astrolabe-expeditions/LittObs_OSOLAMOS/README.md

# LittObs-LAMOS

Ce projet est organisé en plusieurs dossiers principaux, chacun ayant un rôle spécifique :

## Structure des dossiers

- **docs/** : Documentation du projet, tutoriels et guides pour chaque module (électronique, programmation, caisson, etc.).
- **hardware/** : Contient les fichiers liés au matériel, notamment les boîtiers (`enclosures/`) et les circuits imprimés (`pcbs/`).
- **software/** : Code source et applications logicielles du projet.
	- **firmware/** : Microprogrammes embarqués pour les dispositifs électroniques.
		- **Largueur_temporel/** : Exemple de firmware Arduino pour le largueur temporel (`Largueur_temporel.ino`).
	- **mobile/** : Applications mobiles, par exemple le projet pour ESP32 (`esp32_1.aia`).

## Utilisation

Consultez le dossier `docs/` pour les instructions détaillées sur chaque module et le fonctionnement global du projet.
