astrolabe-expeditions/LittObs_OSOLAMOS/docs/module-4-caisson-enrouleur-lamos.md

---
description: >-
  Cette page vous détaille étape par étape comment construire un caisson
  enrouleur LAMOS
---

# Module 4 : Caisson enrouleur LAMOS

## Matériel

<table data-header-hidden><thead><tr><th width="109">Quantité</th><th>Matériel</th></tr></thead><tbody><tr><td>1</td><td><a href="https://www.vis-express.fr/embout-a-sertir-a-oeil-inox-a4/42806-151571-embout-a-a-sertir-a-oeil-inox-a4-diametre-5.html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">Goupille Embout à oeil à sertir Ø 5mm x L. 80mm, inox A4 316</a></td></tr><tr><td>1</td><td><a href="https://rovmaker.org/product/high-torque-40-kg-motor-micro-servo/">Servomoteur High Torque 40 KG Motor Micro Servo</a></td></tr><tr><td>0,5</td><td><a href="https://plaqueplastique.fr/product/plaque-plexiglass-noir-xt-2mm/">Plaque plexiglass épais. 2mm opaque, L. 50cm x H. 30cm</a></td></tr><tr><td>2</td><td><a href="https://plaqueplastique.fr/product/plaque-plexiglass-noir-xt-5mm/">Plaque plexiglass épais. 5mm opaque, L. 50cm x H. 30cm</a></td></tr><tr><td>36</td><td><a href="https://fr.rs-online.com/web/p/vis-a-metaux/0190440">Vis à tête cylindrique pozi M3 x L. 10mm, inox A4 316</a></td></tr><tr><td>4</td><td><a href="https://fr.rs-online.com/web/p/vis-a-metaux/0190513">Vis à tête cylindrique pozi M4 x L. 16mm, inox A4 316</a></td></tr><tr><td>12</td><td><a href="https://fr.rs-online.com/web/p/vis-a-metaux/0189428">Vis à tête cylindrique pozi M4 x L. 30mm, inox A4 316</a></td></tr><tr><td>12</td><td><a href="https://www.vis-express.fr/vis-metaux-tete-hexagonale-th-inox-a4-din-933/37747-2562188-vis-metaux-tete-hexagonale-th-m5x20-inox-a4.html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">Vis métaux Tête hexagonale M5 x 20mm, inox A4 316</a></td></tr><tr><td>16</td><td><a href="https://www.vis-express.fr/ecrou-hexagonal-hu-inox-a4-din-934-din-934-vs0100/37758-2555491-ecrou-hexagonal-hu-m4-inox-a4.html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">Écrou hexagonal M4, inox A4 316</a></td></tr><tr><td>12</td><td><a href="https://www.ruthex.de/fr/collections/gewindeeinsatze/products/ruthex-gewindeeinsatz-m5-50-stuck-rx-m5x9-5-messing-gewindebuchsen">Inserts filetés ruthex M5</a></td></tr><tr><td>30</td><td><a href="https://www.ruthex.de/fr/collections/gewindeeinsatze/products/ruthex-gewindeeinsatz-m3-100-stuck-rx-m3x5-7-messing-gewindebuchsen">Inserts filetés ruthex M3</a></td></tr><tr><td>0,25</td><td><a href="https://www.grossiste3d.com/petg/795-filament-3d-petg-1-kg-noir-175-mm-3008800007691.html">Filament 3D PETG 1kg noir 1,75 mm</a></td></tr><tr><td>1</td><td><a href="https://www.h2r-equipements.com/cordage-et-matelage-pour-bateau/29246-36212-marlow-tresse-dechaussee-excel-d12-dsk78-noir.html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">Drisse Dyneema Ø 3 mm</a></td></tr></tbody></table>

## Outils&#x20;

* Imprimante 3D&#x20;
* Découpeuse laser
* Fer à souder et étain
* Tournevis cruciformes

## Pièces :&#x20;

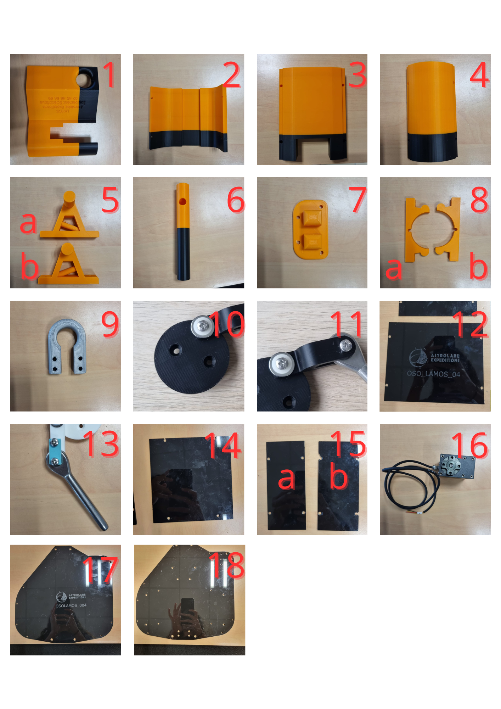
[picture p2: docs/.gitbook/assets/Pièces LAMOS LittObs (8).png]
<figure><figcaption></figcaption></figure>

## **Étape 1 : Impressions 3D**&#x20;

À l'aide d'une imprimante 3D, de filaments PETG et des fichiers ci-dessous, imprimez les pièces 1, 2, 3, 4, 5a et 5b, 6, 7, 8a et 8b, 9, 10 et 11 à 40% de remplissage.&#x20;

[https://github.com/astrolabe-expeditions/LittObs\_LAMOS/tree/896dc8c68939401ac19cc8e68da1dfa3573f5516/hardware/enclosures/body](https://github.com/astrolabe-expeditions/LittObs_LAMOS/tree/896dc8c68939401ac19cc8e68da1dfa3573f5516/hardware/enclosures/body)

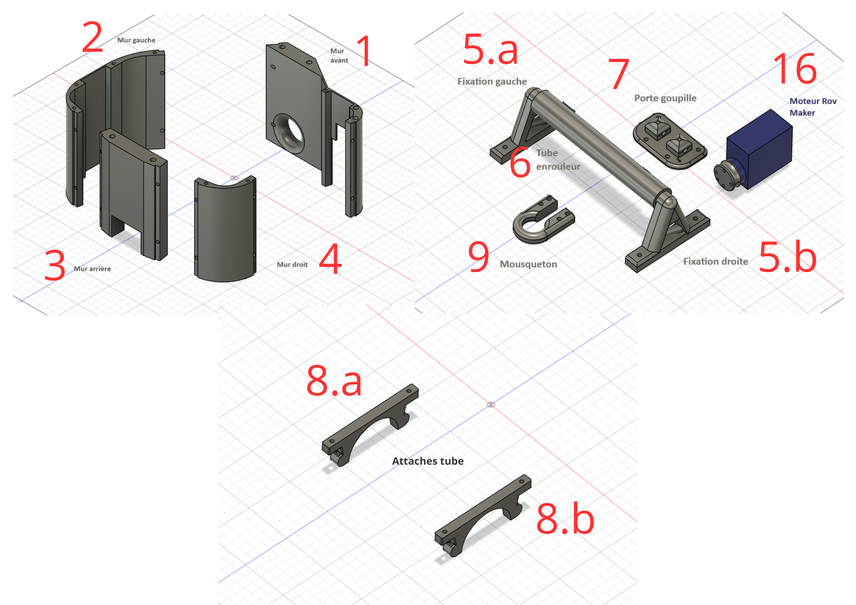
[picture p3: docs/.gitbook/assets/Pièces LAMOS LittObs (9).png]
<figure><figcaption></figcaption></figure>

## **Étape 2 : Découpes laser**&#x20;

À l'aide d'une découpeuse laser et des fichiers ci-dessous, découpez les pièces 14, 15a et 15b dans des plaques de plexiglas de 2mm et les pièces 17 et 18 dans des plaques de plexiglas de 5mm.

[https://github.com/astrolabe-expeditions/LittObs\_LAMOS/tree/896dc8c68939401ac19cc8e68da1dfa3573f5516/hardware/enclosures/body](https://github.com/astrolabe-expeditions/LittObs_LAMOS/tree/896dc8c68939401ac19cc8e68da1dfa3573f5516/hardware/enclosures/body)

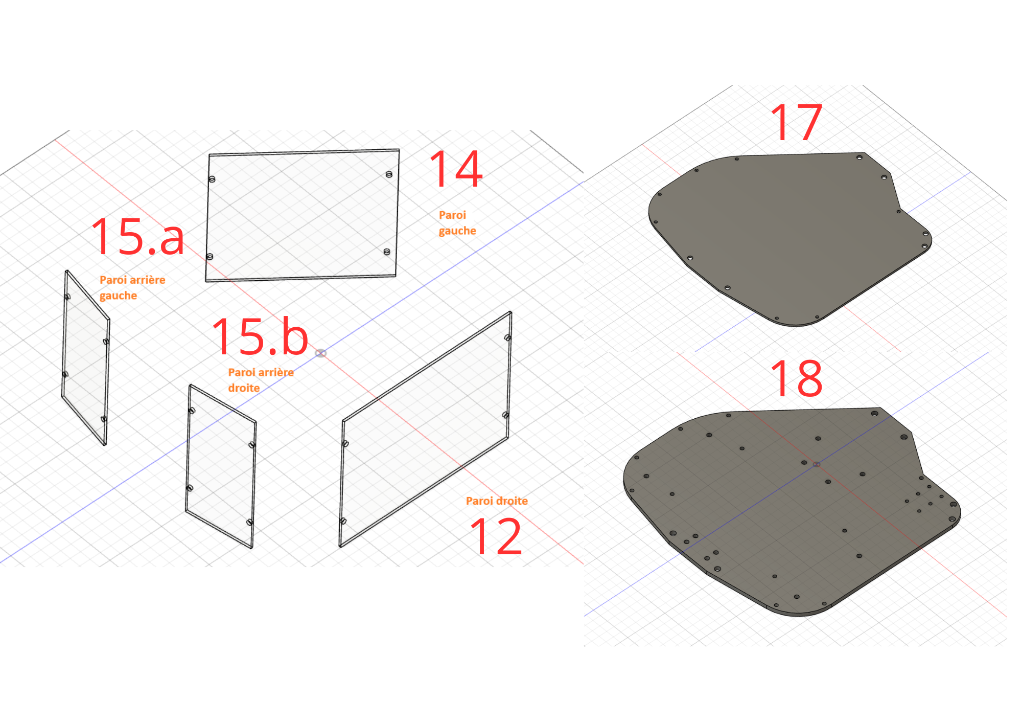
[picture p4: docs/.gitbook/assets/Pièces LAMOS LittObs (10).png]
<figure><figcaption></figcaption></figure>

## **Étape 3 : Insérer les inserts filetés dans les parois 3D**

Positionnez les inserts filetés sur les pièces 3D au niveau des trous prévus à cet effet. Puis, faites chauffer les inserts avec un fer à souder afin de les insérer dans les pièces 3D. (Pas besoin d’inserts pour les pièces : 04, 05a, 05b, 07, 08a et 08b)

Attention à ce que la chaleur du fer à souder ne crée pas des bourrelets autour des inserts ! Le cas échéant, limez les pièces 3D afin de garder une surface lisse.

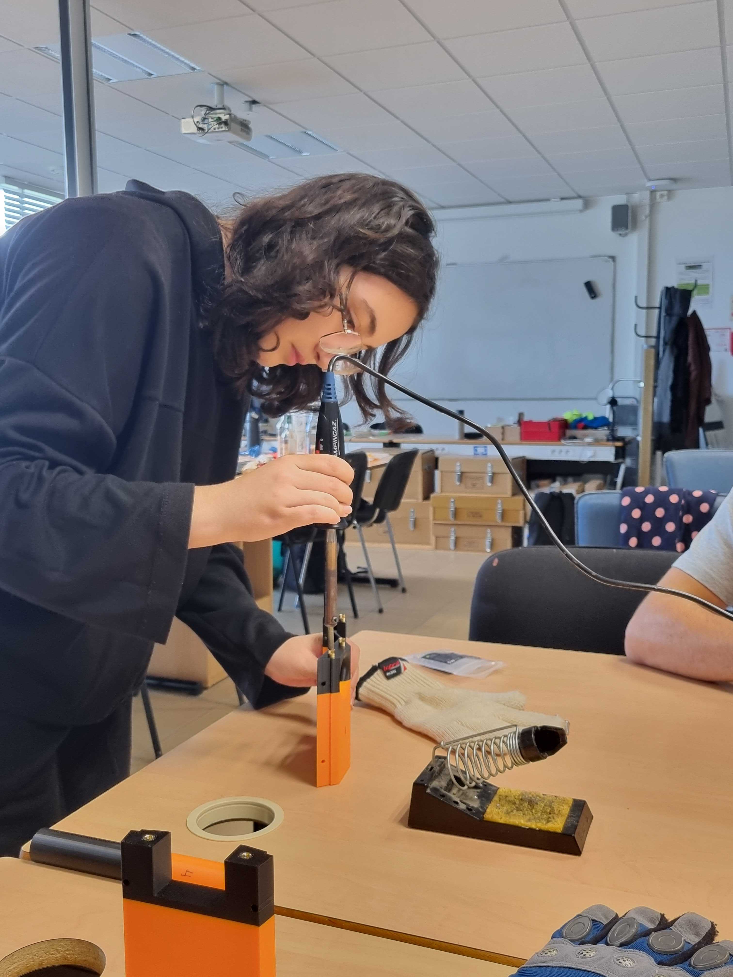
[picture p5: docs/.gitbook/assets/1000056525 (1).jpg]
<div align="center"><figure><figcaption></figcaption></figure></div>

## **Étape 4 : Assemblage des murs et parois**

**À partir du schéma suivant :**

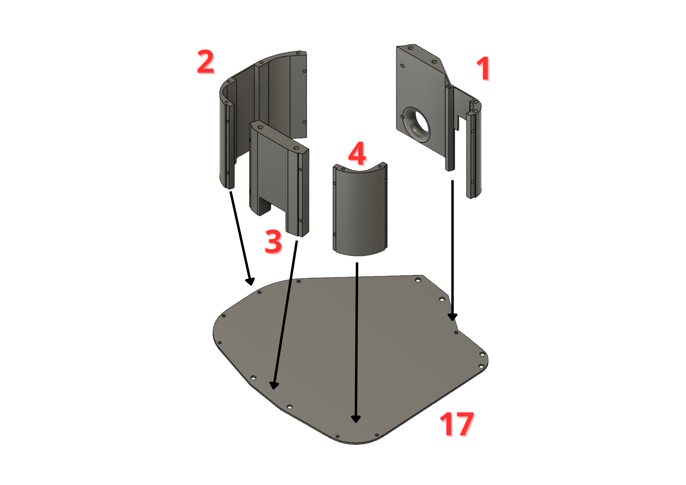
[picture p6: docs/.gitbook/assets/Pièces LAMOS LittObs (11) (1).png]
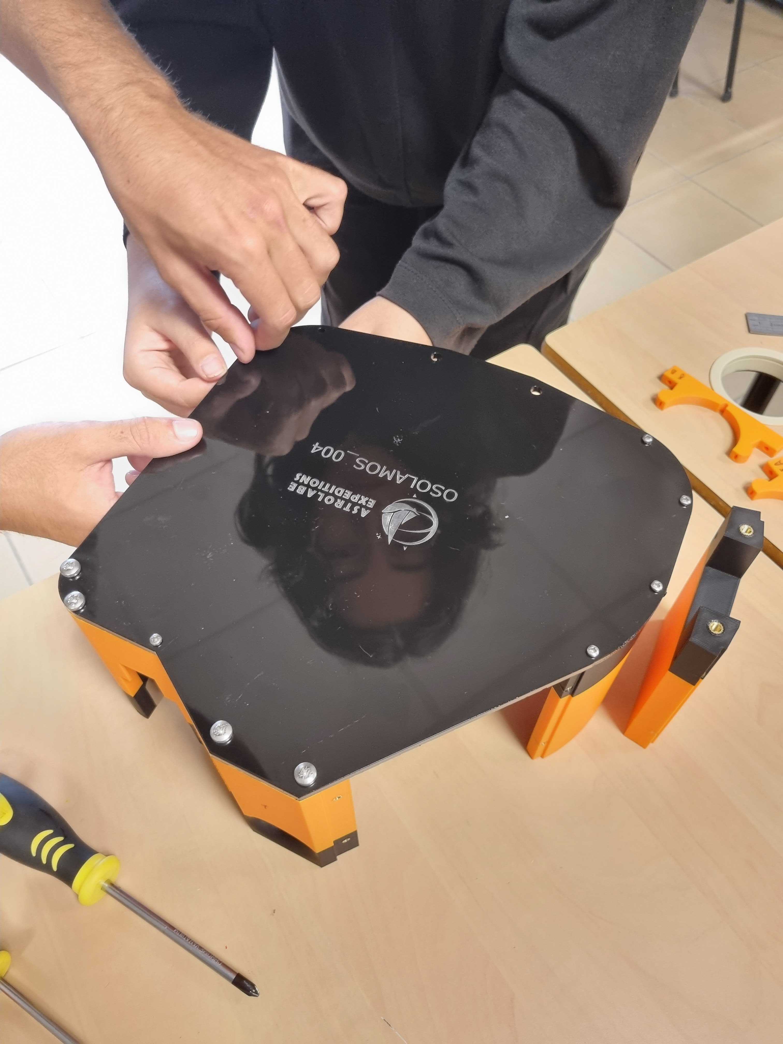
[picture p7: docs/.gitbook/assets/20250918_185842 (1).jpg]
<div><figure><figcaption></figcaption></figure> <figure><figcaption></figcaption></figure></div>

Vissez les pièces 01, 02, 03 et 04 sur la plaque en plexiglas 17

* 01 (mur avant) à l’aide de 1 petite vis M3 10mm et 4 grandes vis M5
* 02 (mur gauche) à l’aide de 4 petites vis M3 10mm
* 03 (mur arrière) à l’aide de 2 grandes vis M5
* 04 (mur droit) à l’aide de 2 petites vis M3 10mm

**À partir du schéma suivant :**

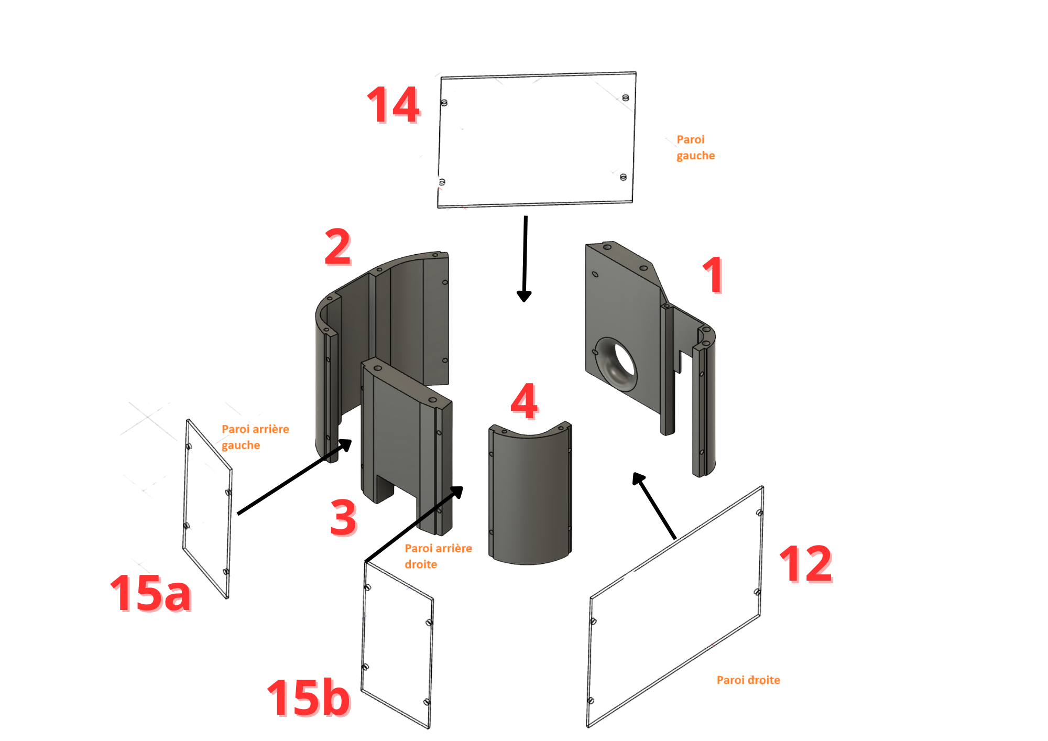
[picture p8: docs/.gitbook/assets/Pièces LAMOS LittObs (12).png]
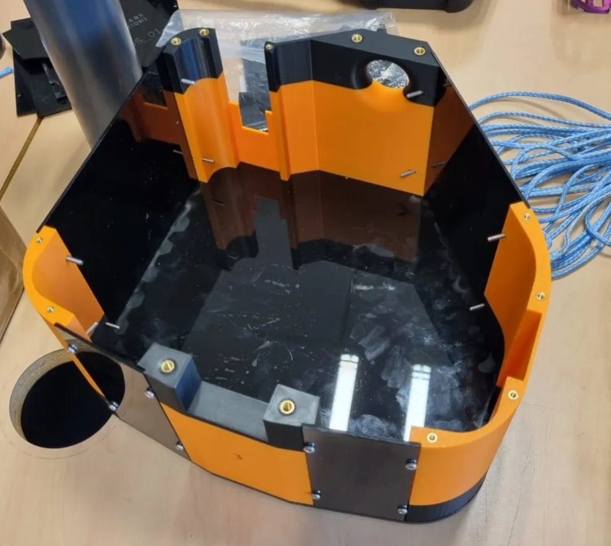
[picture p9: docs/.gitbook/assets/WhatsApp Image 2025-10-08 at 18.09.54.jpeg.png]
<div><figure><figcaption></figcaption></figure> <figure><figcaption></figcaption></figure></div>

* Vissez la paroi arrière gauche (15a) entre les pièces 02 et 03 avec 04 petites vis M3
* Vissez la paroi arrière droite (15b) entre les pièces 03 et 06 avec 04 petites vis M3

<mark style="color:$warning;">ATTENTION les parois 15a et 15b ne font pas la même taille ! 15a est plus petite que 15b</mark>

* Vissez la paroi gauche (14) entre les pièces 02 et 03 avec 4 petites vis M3
* Vissez la paroi droite (19) entre les pièces 01 et 06 avec 4 petites vis M3

Si les plaques ne se positionnent pas bien face aux inserts, créez un peu de jeu avec les vis.

## **Étape 5 : Fixer et enrouler la drisse dans la bobine**

**Insérer la drisse 6mm dans l'enrouleur (6) au niveau du trou prévu à cet effet, puis réaliser un nœud de blocage. Si le trou n'est pas adapté au diamètre du bout, ne pas hésiter à repercer l'enrouleur d'un diamètre plus adapté).**

**Enrouler la longueur totale du bout autour de la bobine. Puis placer la bobine dans les 2 supports (5a et 5b).**

## **Étape 5 : Assembler le système de largage**

* Assembler le système de largage goupille :&#x20;
  * En vissant la bielle (10) avec la manivelle (11) à l’aide d’une vis M4 et d’une ou deux rondelles
  * En fixant la goupille (13) sur la manivelle par l'intermédiaire du petit anneau imprimé en 3D ainsi qu'un vis M4

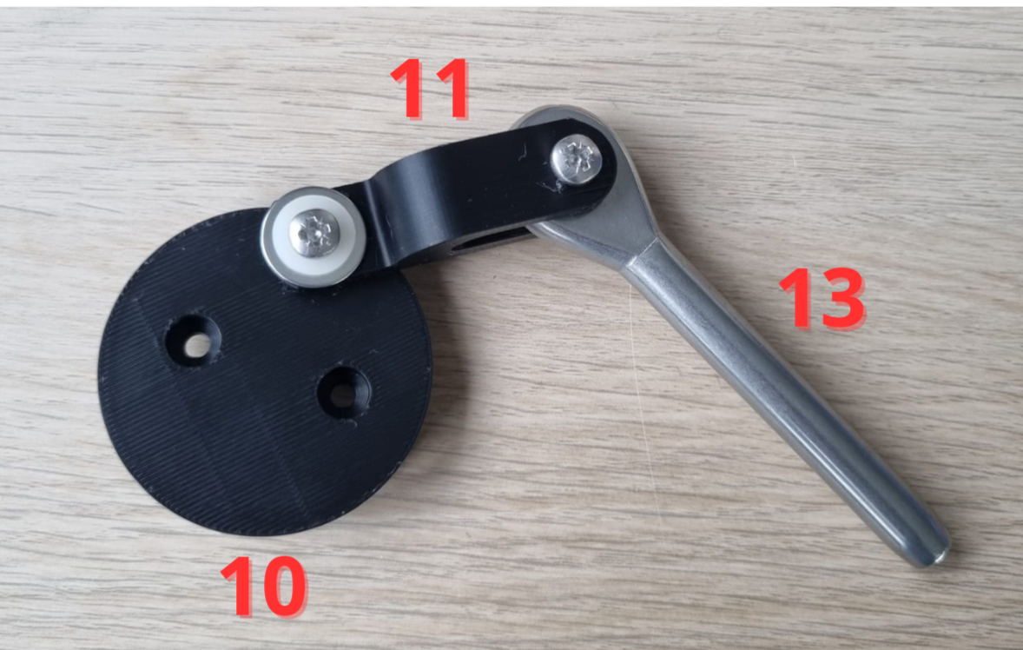
[picture p10: docs/.gitbook/assets/Pièces LAMOS LittObs (14).png]
<figure><figcaption></figcaption></figure>

**À partir du schéma suivant et en suivant l'ordre des étapes :**

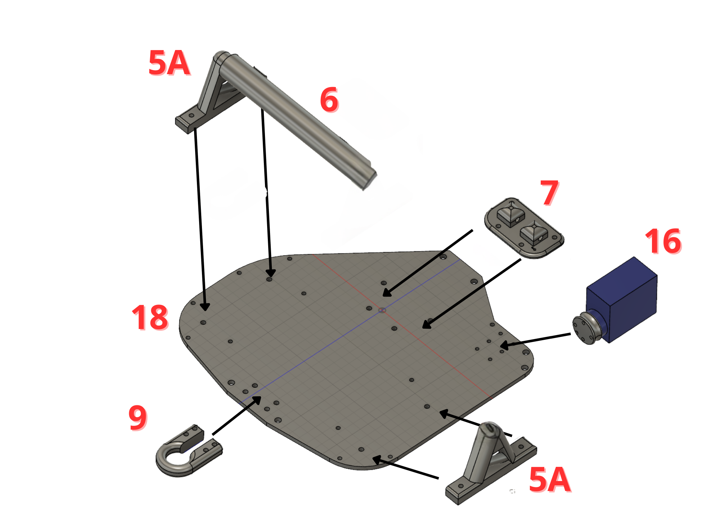
[picture p11: docs/.gitbook/assets/Pièces LAMOS LittObs (13).png]
<figure><figcaption></figcaption></figure>

<div><figure><figcaption></figcaption></figure> <figure><figcaption></figcaption></figure></div>

* Fixer sur la seconde paroi plexiglas (18) les pièces suivantes :
  *   Le servomoteur (16) avec 6 petites visses M3. Le système de largage précédemment assemblé doit être fixé sur la partie rotative du servomoteur (16) à l'aide de vis à tête fraisée M4 de 10mm

      *

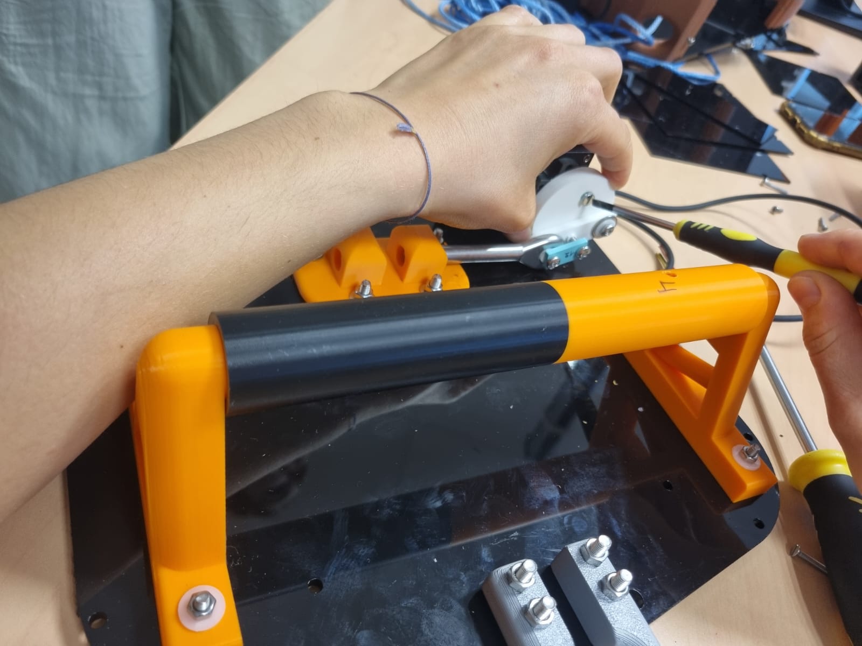
[picture p12: docs/.gitbook/assets/WhatsApp Image 2025-09-25 at 19.36.06 (1) (1).jpeg]
          <figure><figcaption></figcaption></figure>

  * Le porte goupille (7) à l’aide de 4 grandes vis M5 et 4 écrous. Puis glisser la goupille (13).
  * L'ensemble de l'enrouleur comprenant les fixation gauche et droites (5a et 5b) ainsi que la bobine et la drisse (6)
  * Le mousqueton (9) à l’aide de 4 grandes vis M5 et 4 écrous.
* Sur l’autre face de la paroi plexiglas (18), fixer les pièces 8a et 8b avec des 4 vis M4 de 25mm

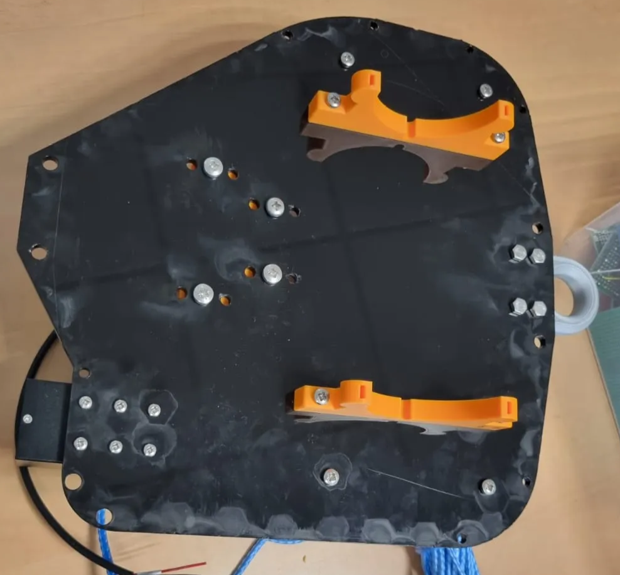
[picture p13: docs/.gitbook/assets/WhatsApp Image 2025-10-08 at 18.09.49.jpeg.png]
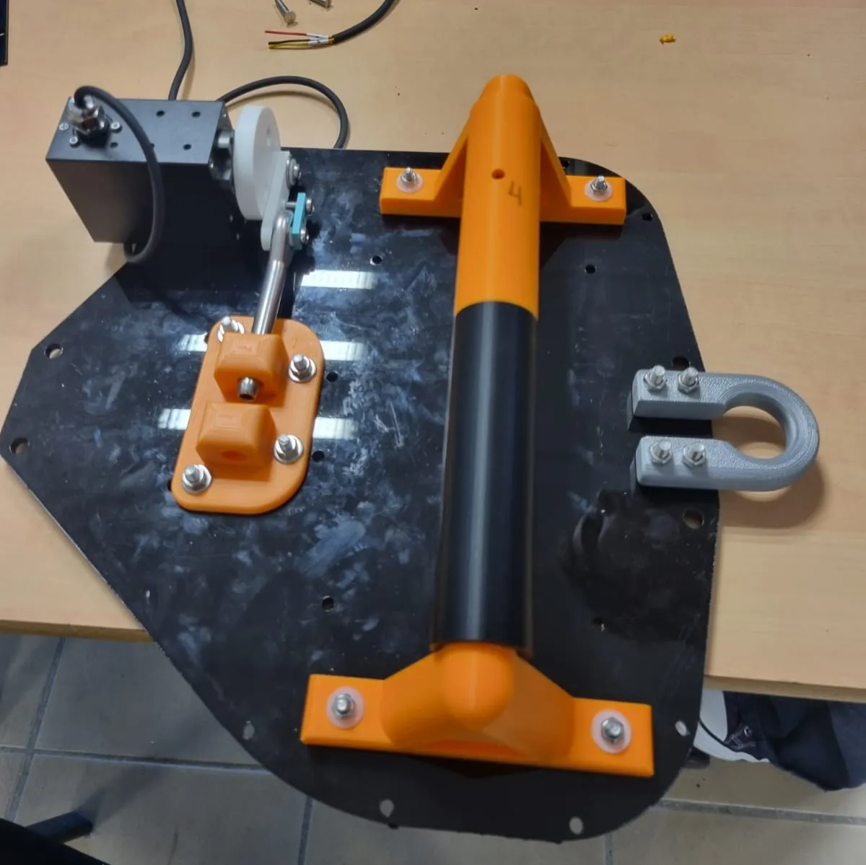
[picture p14: docs/.gitbook/assets/WhatsApp Image 2025-09-25 at 19.36.00.jpeg.png]
<div><figure><figcaption></figcaption></figure> <figure><figcaption></figcaption></figure></div>

<mark style="color:$warning;">Attention à visser les écrous du côté des pièces 3D afin de garder la surface extérieure de la plaque facilement manipulable à la main !</mark>

## **Étape 6 : Assembler l'ensemble**

Visser la pièce 18 avec les murs 01, 02,03 et 04 à l'aide de vis M5 et M3 10mm.

<div><figure><figcaption></figcaption></figure> <figure><figcaption></figcaption></figure></div>
