astrolabe-expeditions/LittObs_OSOLAMOS/docs/module-1-carte-electronique-lamos.md

---
description: Page en construction...
---

# Module 1 : Carte électronique LAMOS

## Matériel :&#x20;

<table><thead><tr><th width="118.33331298828125">Quantité</th><th>Matériel</th></tr></thead><tbody><tr><td>1</td><td><a href="https://jlcpcb.com/">PCB à imprimer</a></td></tr><tr><td>1</td><td><a href="https://www.gotronic.fr/art-module-firebeetle-esp32-dfr0478-26810.htm">Module FireBeetle ESP32 DFR0478</a></td></tr><tr><td>1</td><td><a href="https://www.gotronic.fr/art-module-rtc-i2c-ds3231m-dfr0641-32243.htm">Module RTC I2C DS3231M DFR0641</a></td></tr><tr><td>1</td><td><a href="https://eu.robotshop.com/products/servocity-xt30-lead-fh-mc-300mm-length?qd=b64ee6ad88995350cdadd1edb00deb69">Connecteur XT30 femelle</a></td></tr><tr><td>1</td><td><a href="https://www.gotronic.fr/art-connecteur-nsk254-4-15396.htm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">Connecteur 4 broches mâle</a></td></tr><tr><td>1</td><td><a href="https://www.gotronic.fr/art-connecteur-nsk254-4f-37679.htm">Connecteur 4 broches femelle</a></td></tr><tr><td>2</td><td><a href="https://www.gotronic.fr/art-connecteur-fh1x18-35647.htm">Connecteurs femelles FH1X18 18 contacts, 2,54mm</a></td></tr><tr><td>2</td><td><a href="https://www.gotronic.fr/art-connecteur-fh1x7-22733.htm">Connecteurs femelles FH1X7 7 contacts, 2,54mm</a></td></tr><tr><td>1</td><td><a href="https://www.gotronic.fr/art-10-resistances-1-4w-470-8486-2571.htm">Résistance 1/2W 470 Ω</a></td></tr><tr><td>1</td><td><a href="https://www.gotronic.fr/art-assortiment-de-50-leds-36117.htm">Led 5mm verte 2 mA</a></td></tr><tr><td>1</td><td><a href="https://fr.rs-online.com/web/p/interrupteurs-a-glissiere/7347296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;matchtype=&#x26;&#x26;gclsrc=aw.ds&#x26;gad_source=1&#x26;gad_campaignid=20705694603&#x26;gclid=Cj0KCQjw6bfHBhDNARIsAIGsqLhk2r94cKffPtzz0kw8niXHl5YC2BkwRsuroMJeFyVusfk3wwECJnkaAnhsEALw_wcB">Commutateur à glissière, 1RT, Verrouillable, 5A, 28 Vcc</a></td></tr><tr><td>1</td><td><a href="https://eu.robotshop.com/fr/products/bluerobotics-wetlink-penetrator-lc-1-pack-m10-55-mm">BlueRobotics WetLink Penetrator M10-5.5mm-LC</a></td></tr><tr><td>1</td><td><a href="https://eu.robotshop.com/products/bluerobotics-switch-5a?qd=ceadcef33edf15892b1a770253882463">BlueRobotics Switch 5A</a></td></tr><tr><td>1</td><td><a href="https://www.gotronic.fr/art-module-bouton-poussoir-on-off-6a-2808-24231.htm">Pololu Mini Pushbutton Power Switch LV from 2.2 V to 20 V</a></td></tr><tr><td>1</td><td><a href="https://www.nkon.nl/fr/samsung-inr18650-35e.html">Batterie 18650 3400mAh 8A (/!\ la référence change régulièrement)</a></td></tr><tr><td>1</td><td><a href="https://www.nkon.nl/fr/1x-18650-batterijhouder-met-klemmen-en-losse-draden.html">Support batterie 18650</a></td></tr><tr><td>3</td><td><a href="https://www.nkon.nl/fr/samsung-inr18650-35e.html">Batterie 18650 3400mAh 8A (/!\ la référence change régulièrement)</a></td></tr><tr><td>1</td><td><a href="https://fr.aliexpress.com/item/1005007538224600.html?UTABTest=aliabtest110382_7684&#x26;src=google&#x26;src=google&#x26;albch=shopping&#x26;acnt=248-630-5778&#x26;slnk=&#x26;plac=&#x26;mtctp=&#x26;albbt=Google_7_shopping&#x26;gclsrc=aw.ds&#x26;albagn=888888&#x26;ds_e_adid=&#x26;ds_e_matchtype=&#x26;ds_e_device=c&#x26;ds_e_network=x&#x26;ds_e_product_group_id=&#x26;ds_e_product_id=fr1005007538224600&#x26;ds_e_product_merchant_id=5422775200&#x26;ds_e_product_country=FR&#x26;ds_e_product_language=fr&#x26;ds_e_product_channel=online&#x26;ds_e_product_store_id=&#x26;ds_url_v=2&#x26;albcp=19000710609&#x26;albag=&#x26;isSmbAutoCall=false&#x26;needSmbHouyi=false&#x26;gad_source=1&#x26;gclid=Cj0KCQiA_NC9BhCkARIsABSnSTbT6iz-yaQ0HdWFSCa2HC2KcABTsam-IVa1xElwvAvcU64eQtP46s4aAioJEALw_wcB&#x26;aff_fcid=efed48fa4b1e4580805efe8ff2b32c29-1739892689495-01463-UneMJZVf&#x26;aff_fsk=UneMJZVf&#x26;aff_platform=aaf&#x26;sk=UneMJZVf&#x26;aff_trace_key=efed48fa4b1e4580805efe8ff2b32c29-1739892689495-01463-UneMJZVf&#x26;terminal_id=62d61d252d2149ddb2b1251d52458886&#x26;OLP=1098900508_f_group4&#x26;o_s_id=1098900508&#x26;afSmartRedirect=n&#x26;gatewayAdapt=glo2fra">Carte de protection de batterie BMS 3S 20A 12.6V</a></td></tr><tr><td>1</td><td><a href="https://eu.robotshop.com/products/servocity-xt30-lead-mh-fc-300mm-length?qd=b077e74b9c723d089f742c476480a82b">Connecteur XT30 mâle</a></td></tr><tr><td>1</td><td><a href="https://www.amazon.fr/TA-VIGOR-Gaine-thermor%C3%A9tractable-batterie-18650/dp/B0DZ2KYX4D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;dib=eyJ2IjoiMSJ9._vSXqGemJ-ZPZgqzORLRd7WxjtNvmwjq-jpn86XdISOZswNncPag6kXENnDYJz51sSau_qbNMs_-zvGCprQUulaiVunPPsxY30zscNwd9NiTfXLkQ2FCDaoJy-TWTKNnzmXdDwzKZMmS5CrKFgb_ZMFJineflT9CMSY6Q-8jB-lhD84CmdnKK22sxJZAydFpx3gvPai1lcENDaI4fB3vYmCzhDbFZ2-f2MD9Otr_LqUkkAHDlaWsxJYoISMxqkUdjDKXuG49mrGVLCF9tHdUJeGlrdJJO9iX84ZJ8-thf84.rUn-jwb9zU7lFT0vi1m9xXH5IOB2vopwIP2zC5o8D7E&#x26;dib_tag=se&#x26;keywords=Gaine%2Bthermo-r%C3%A9tractable%2BPVC%2Bbleue%2Bpour%2Bbatterie%2B18650%2C%2BL.%2B85mm%2B1m&#x26;qid=1760692967&#x26;sbo=RZvfv%2F%2FHxDF%2BO5021pAnSA%3D%3D&#x26;sprefix=gaine%2Bthermo-r%C3%A9tractable%2Bpvc%2Bbleue%2Bpour%2Bbatterie%2B18650%2C%2Bl.%2B85mm%2B1m%2Caps%2C103&#x26;sr=8-6&#x26;th=1">Gaine thermo-rétractable PVC bleue pour batterie 18650, L. 85mm</a></td></tr><tr><td>1</td><td><a href="https://www.nkon.nl/fr/nikkel-weldingstrip-7mm-0-12mm.html">Bande de soudure au nickel de 1 mètre - 7 mm * 0,12 mm</a></td></tr></tbody></table>

## Outils :&#x20;

*
  Fils électriques
* Ruban adhésif d'électricité chatterton
* Fer à souder
* Étain
* Soudeuse par points à pédale
* Multimètre
* Lunettes de protection
* Pince coupante et pince à dénuder

### Commande ou impression du PCB

Commander le PCB via un site tel que JLCPCB ou le découper via une fraiseuse numérique CNC grâce aux fichiers gerber "[Gerber\_PCB\_LAMOS\_Moteur](https://github.com/astrolabe-expeditions/LittObs_OSOLAMOS/tree/d8edebc3e5015c4b25bd3d427265ff356d61ff94/hardware/pcbs/Gerber_PCB_LAMOS_Moteur)"

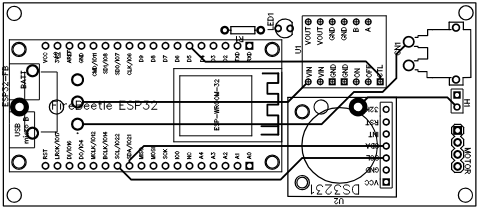
[picture p29: docs/.gitbook/assets/image.png]
<figure><figcaption></figcaption></figure>

### Soudure des composants sur le PCB

1. **Souder sur le PCB les composants indiqués ci-dessous comme sur la photo :**

* Le commutateur
* Le connecteur 4 broches pour relier le servomoteur&#x20;
* Le connecteur 2 broches pour relier l'interrupteur étanche
* Le connecteur femelle XT30
* La LED et sa résistance
* Les 2 supports 18 contacts pour l'ESP32
* Le support 7 contacts pour l'horloge RTC
* Le Pololu Mini Pushbutton&#x20;

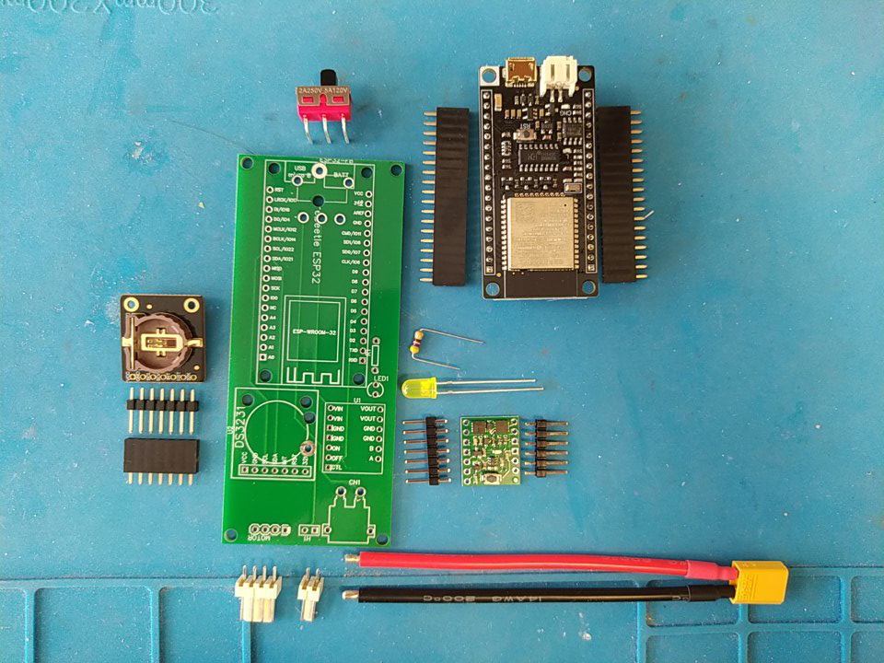
[picture p30: docs/.gitbook/assets/IMG_20260128_114804.jpg]
<figure><figcaption></figcaption></figure>

<figure><figcaption></figcaption></figure>

2. Positionner les 2 supports de l'ESP32 et les souder. Faire de même pour le support de l'horloge&#x20;

<figure><figcaption></figcaption></figure>

3. Souder le support de batterie 18650 comme ci-dessous

<figure><figcaption></figcaption></figure>

<figure><figcaption></figcaption></figure>
