astrolabe-expeditions/LittObs_OSOLAMOS/docs/SUMMARY.md

# Table of contents

* [LittObs | LArgeur pour MOuillage Sous-marin (LAMOS)](README.md)
* [Module 1 : Carte électronique LAMOS](module-1-carte-electronique-lamos.md)
* [Module 2 : Programmation PCB](module-2-programmation-pcb.md)
* [Module 3 : Caisson moteur LAMOS](module-3-caisson-moteur-lamos.md)
* [Module 4 : Caisson enrouleur LAMOS](module-4-caisson-enrouleur-lamos.md)
* [Module 5 : Ligne de mouillage](module-5-ligne-de-mouillage.md)
* [Module 6 : Pack batterie 12V 3S1P](module-6-pack-batterie-12v-3s1p.md)
