astrolabe-expeditions/LittObs_OSOLAMOS/docs/module-5-ligne-de-mouillage.md

---
description: Page en construction...
---

# Module 5 : Ligne de mouillage

## Matériel

| Quantité | Matériel |
| --- | --- |
| 1 | [Flotteur Nokalon Central 11l 950m D.280mm](https://www.mncommercial.fr/accueil/62-260-flotteur-type-nokalon.html#/85-diametre-280) |
| 1 | [Anneau rond Ø 8mm x 40mm, inox A4 316](https://www.h2r-equipements.com/sangle-et-sandow-elastique-pour-bateau/19350-23755-anneau-inox-10x60mm.html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) |
| 20 | [Drisse polyester Ø 8mm](https://www.h2r-equipements.com/cordage-technique-bateau/6482-7354-lancelin-matt-polyester-32.html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) |
| 13 | [Drisse Polyester Ø 6mm](https://www.h2r-equipements.com/cordage-technique-bateau/6482-7349-lancelin-matt-polyester-32.html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) |
| 1 | [Ancre plate 12 kg](https://www.h2r-equipements.com/ancre-de-mouillage-pour-bateau/1430-1305-plastimo-ancre-plate.html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) |
| 1 | [Disque fonte 10kg](https://www.decathlon.fr/p/disque-de-musculation-fonte-10kg-28mm-disque-de-fonte-a-80-percent-recyclee/_/R-p-348895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\&gad_campaignid=1499014779\&gad_source=1\&gclid=CjwKCAiA95fLBhBPEiwATXUsxE3-FdeqBwDc1AOyt91dZ5QTpTi-Abf4GlEnp9Q_pRq9BrDVuvsZixoCC3UQAvD_BwE\&utm_campaign=fr_t-perf_ct-shopp_n-shopping-mq-fitness-mp_ts-bra_f-cv_o-roas_\&utm_medium=sea\&utm_source=google\&utm_term=_n-shopping-mq-fitness-mp_ts-bra_pt-pb_yy-musculation-crosstraining_poids-de-musculation) |

## Outils&#x20;

* Coupe cordage
* Briquet tempête
