astrolabe-expeditions/LittObs_OSOLAMOS/docs/.gitbook/assets/image (23).png

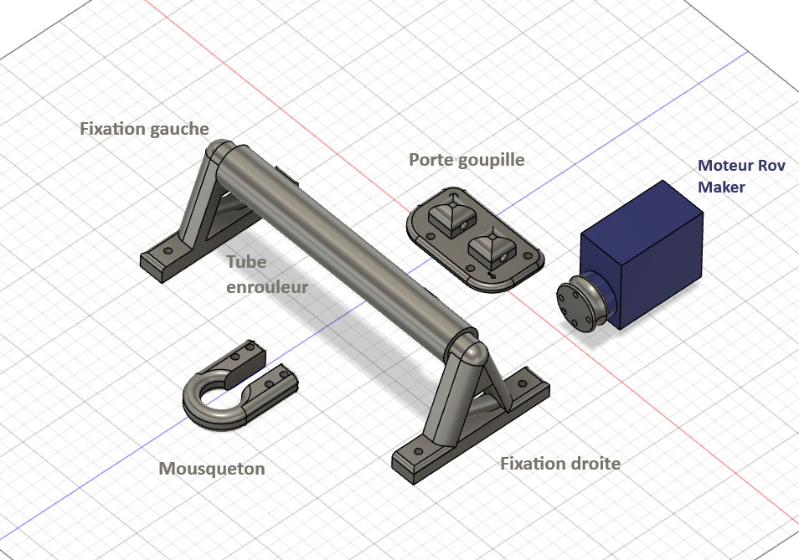
docs/.gitbook/assets/image (23).png
