astrolabe-expeditions/LittObs_OSOLAMOS/docs/.gitbook/assets/image (24).png

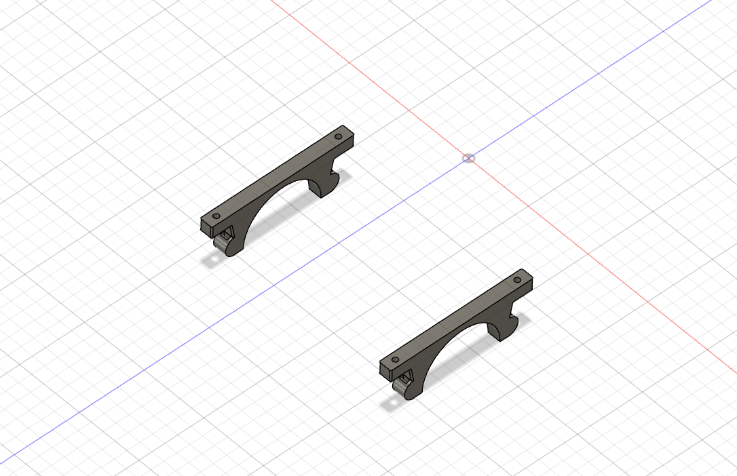
docs/.gitbook/assets/image (24).png
