astrolabe-expeditions/LittObs_OSOLAMOS/docs/.gitbook/assets/image (25).png

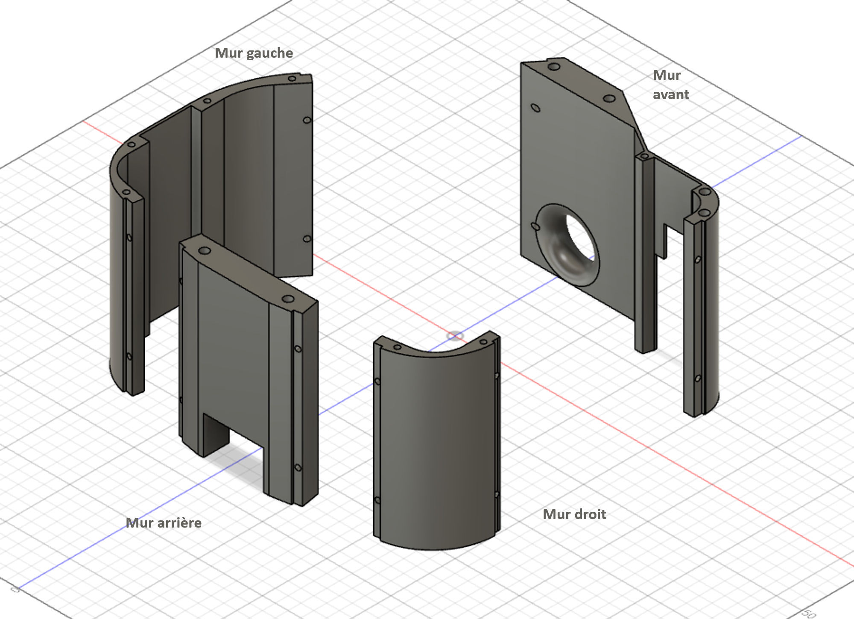
docs/.gitbook/assets/image (25).png
