astrolabe-expeditions/LittObs_OSOLAMOS/docs/.gitbook/assets/IMG_20250108_122626.jpg

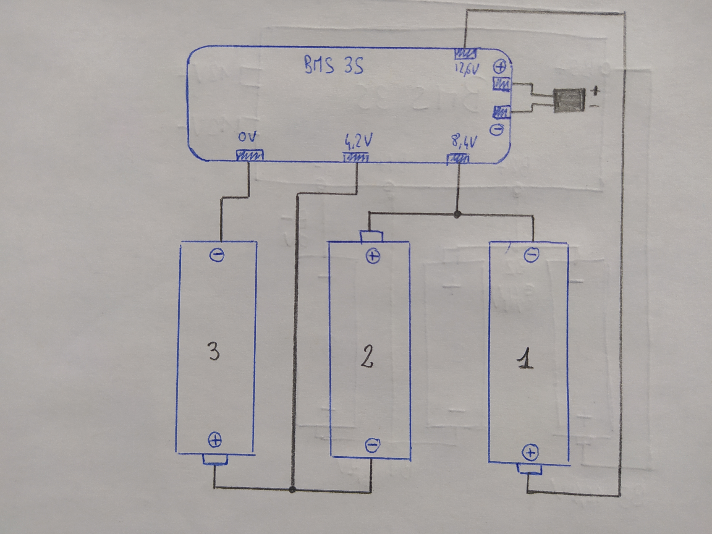
docs/.gitbook/assets/IMG_20250108_122626.jpg
