astrolabe-expeditions/LittObs_OSOLAMOS/docs/.gitbook/assets/IMG_20250527_165919.jpg

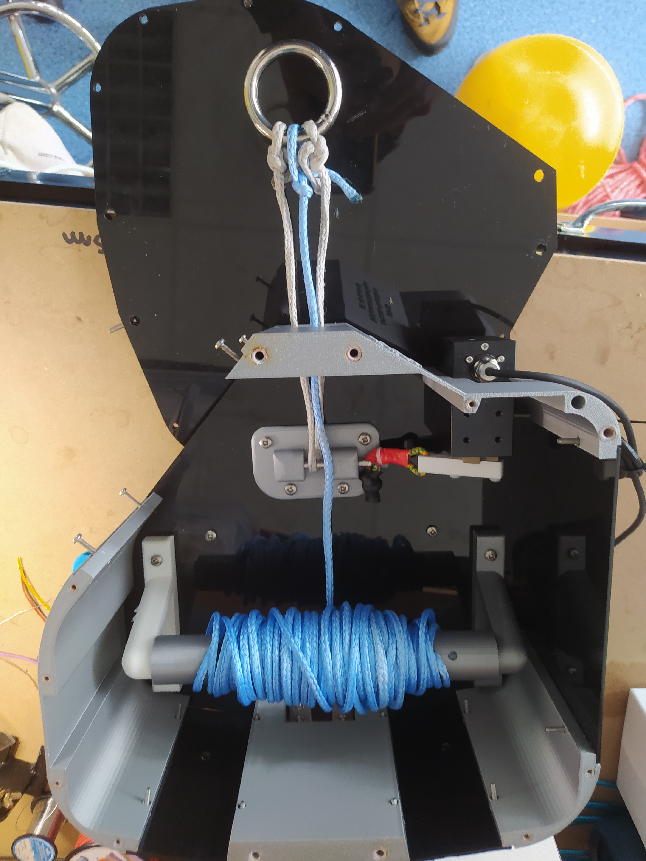
docs/.gitbook/assets/IMG_20250527_165919.jpg
