astrolabe-expeditions/LittObs_OSOLAMOS/docs/.gitbook/assets/Page en cour de création.png

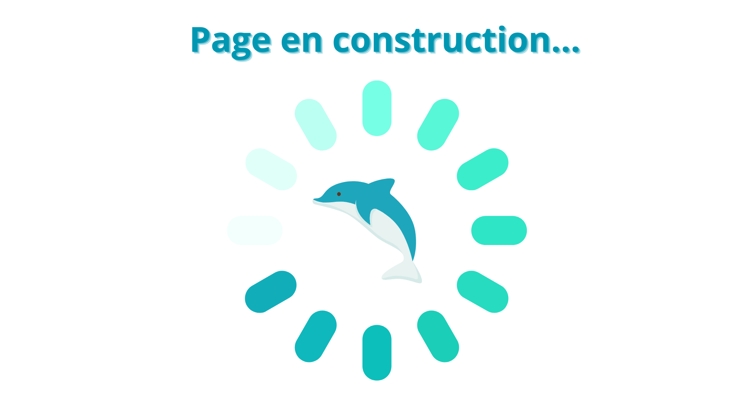
docs/.gitbook/assets/Page en cour de création.png
