astrolabe-expeditions/LittObs_OSOLAMOS/docs/.gitbook/assets/Pièces LAMOS LittObs (5) (1).png

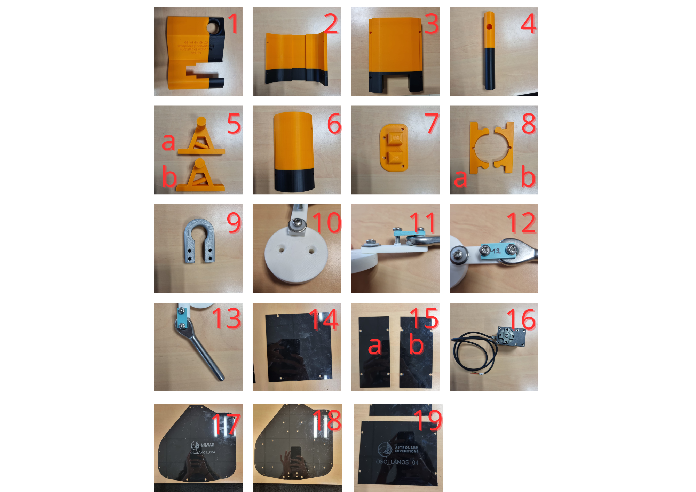
docs/.gitbook/assets/Pièces LAMOS LittObs (5) (1).png
