astrolabe-expeditions/LittObs_OSOLAMOS/hardware/enclosures/body/complete_LAMOS.stl

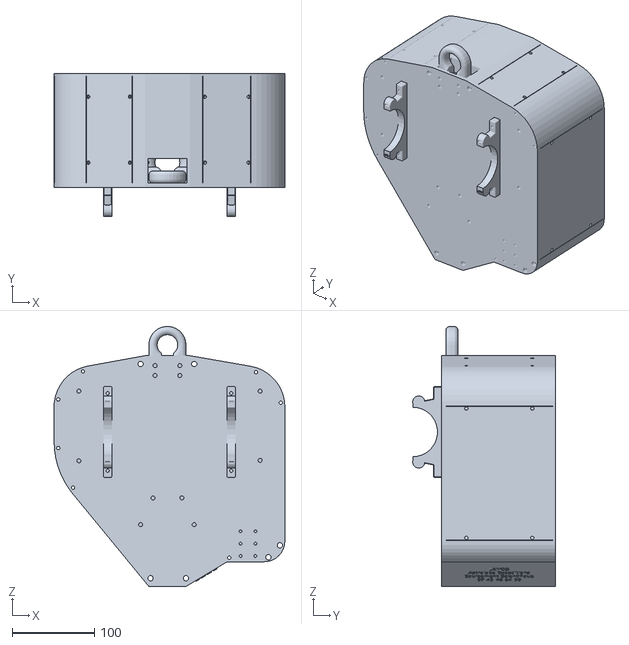
[picture p54: CAD file, 2026-02-19]
hardware/enclosures/body/complete_LAMOS.stl
280.0 x 173.2 x 315.5
