astrolabe-expeditions/LittObs_OSOLAMOS/docs/.gitbook/assets/6_enrouleur.stl

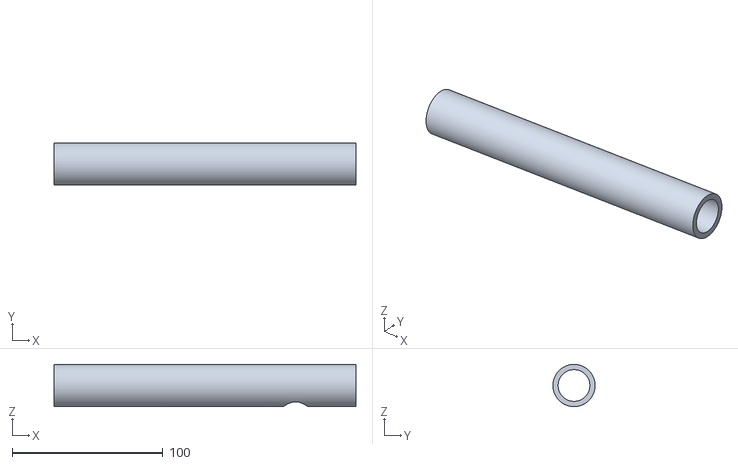
[picture p55: CAD file, 2026-01-15]
docs/.gitbook/assets/6_enrouleur.stl
200.0 x 28.0 x 28.0
