astrolabe-expeditions/LittObs_OSOLAMOS/hardware/enclosures/box_elec/Sensor_Protection.stl

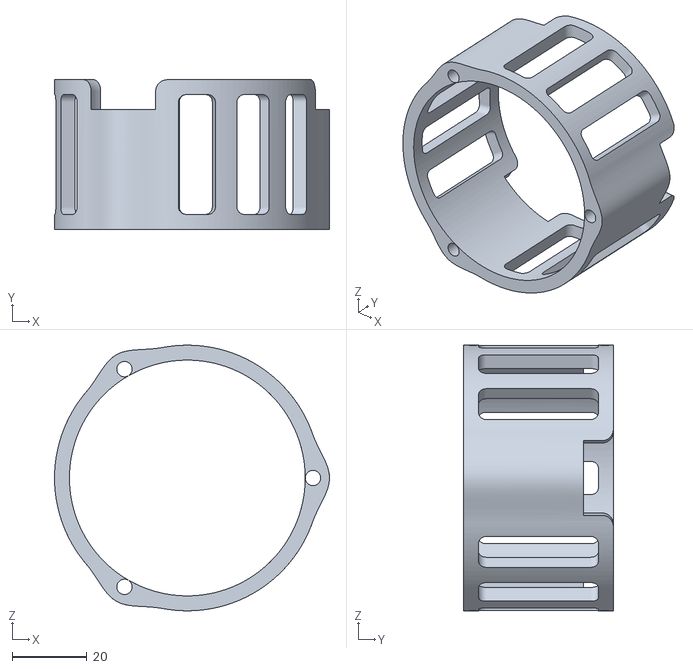
[picture p56: CAD file, 2026-02-23]
hardware/enclosures/box_elec/Sensor_Protection.stl
73.5 x 40.0 x 71.0
