astrolabe-expeditions/LittObs_OSOLAMOS/hardware/enclosures/body/10_largage_moteur_bielle.stl

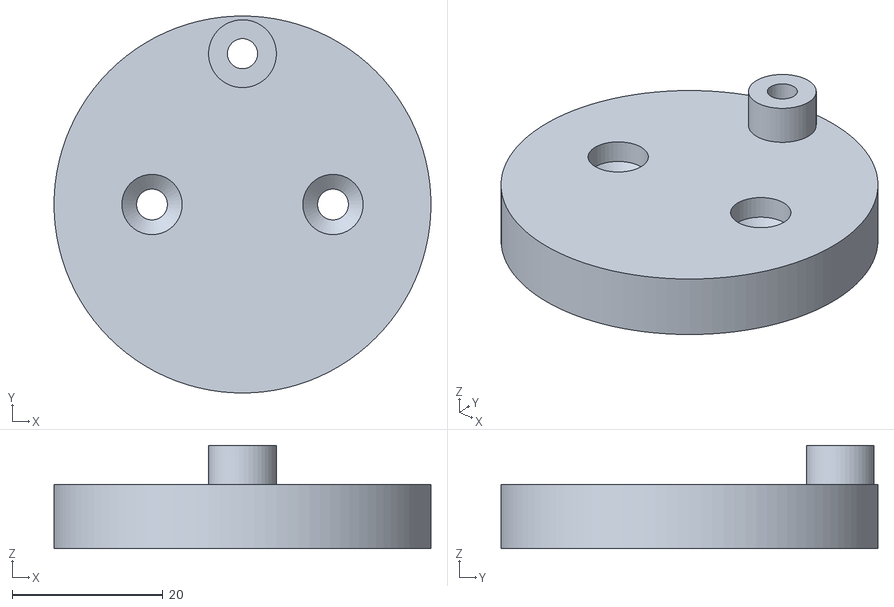
[picture p57: CAD file, 2026-02-19]
hardware/enclosures/body/10_largage_moteur_bielle.stl
50.0 x 50.0 x 13.7
