astrolabe-expeditions/LittObs_OSOLAMOS/hardware/enclosures/box_elec/PCB_Support.stl

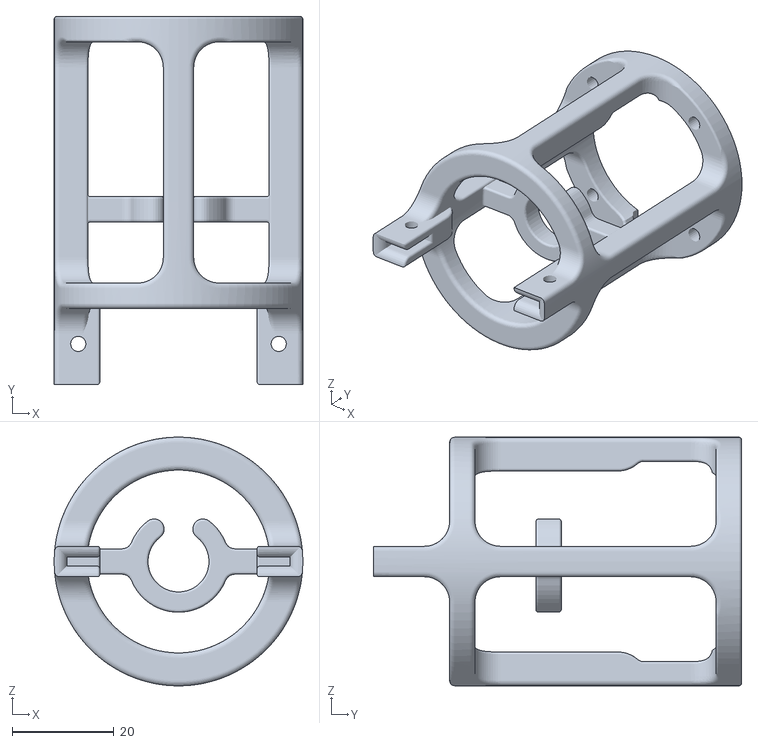
[picture p58: CAD file, 2026-02-23]
hardware/enclosures/box_elec/PCB_Support.stl
49.0 x 72.5 x 49.0
