astrolabe-expeditions/LittObs_OSOLAMOS/hardware/enclosures/body/11_largage_moteur_cylindre.stl

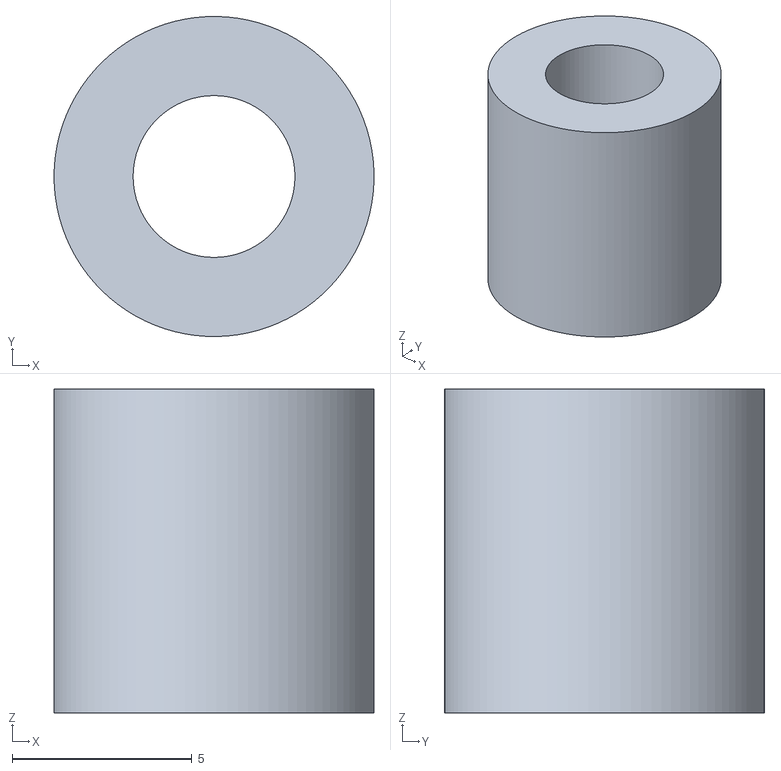
[picture p59: CAD file, 2026-02-19]
hardware/enclosures/body/11_largage_moteur_cylindre.stl
8.90 x 8.90 x 9.00
