astrolabe-expeditions/LittObs_OSOLAMOS/hardware/enclosures/box_elec/PCB_Holder.stl

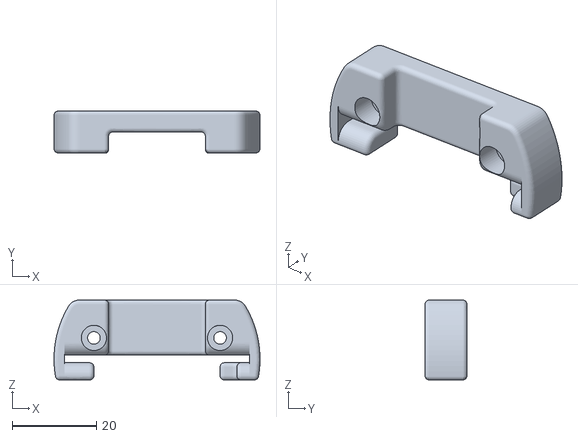
[picture p60: CAD file, 2026-02-23]
hardware/enclosures/box_elec/PCB_Holder.stl
49.0 x 10.0 x 19.0
