astrolabe-expeditions/LittObs_OSOLAMOS/hardware/enclosures/body/6_Enrouleur_colerette.stl

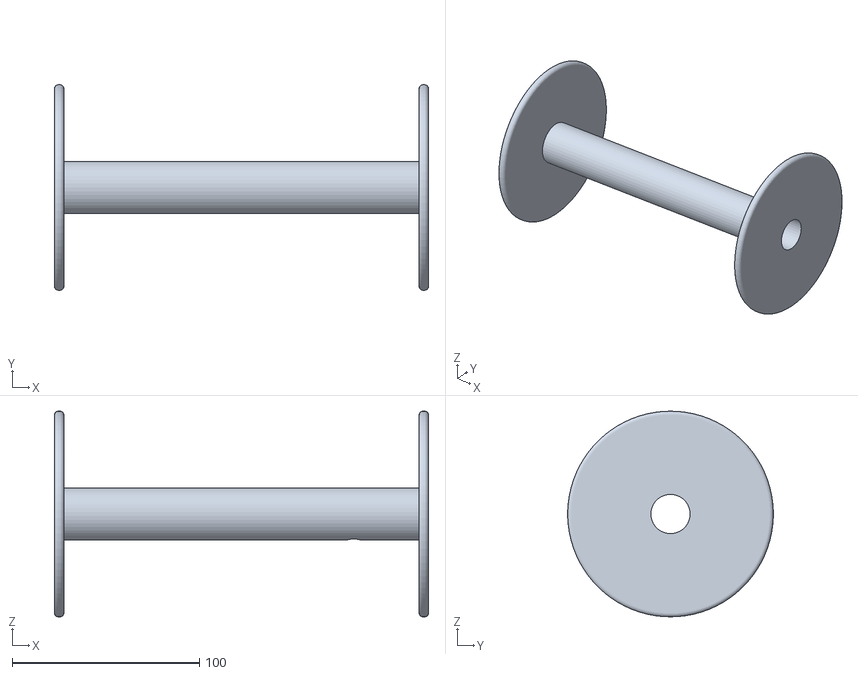
[picture p61: CAD file, 2026-02-19]
hardware/enclosures/body/6_Enrouleur_colerette.stl
200.0 x 109.9 x 110.0
