astrolabe-expeditions/LittObs_OSOLAMOS/hardware/enclosures/body/11_largage_moteur_manivelle.stl

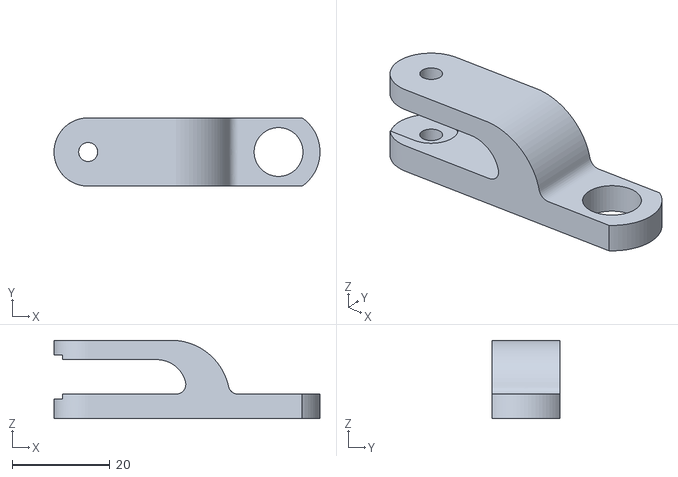
[picture p62: CAD file, 2026-02-19]
hardware/enclosures/body/11_largage_moteur_manivelle.stl
54.5 x 14.0 x 16.0
