astrolabe-expeditions/LittObs_OSOLAMOS/hardware/enclosures/body/attache_tube_BlueRobotics.stl

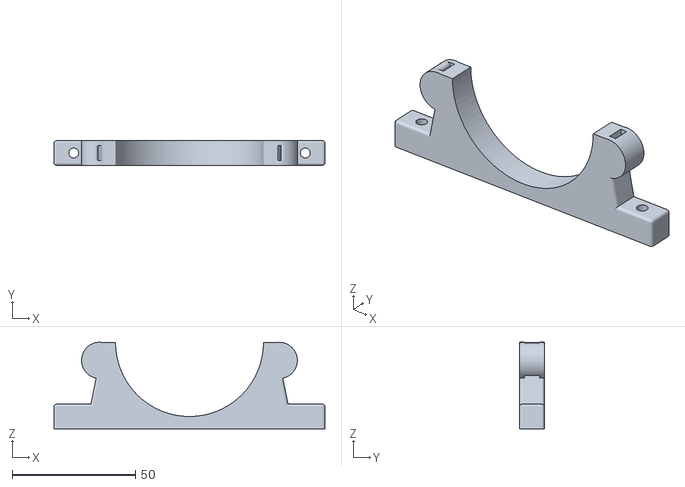
[picture p63: CAD file, 2026-02-19]
hardware/enclosures/body/attache_tube_BlueRobotics.stl
110.0 x 10.0 x 35.2
