astrolabe-expeditions/LittObs_OSOLAMOS/hardware/enclosures/body/5b_fixation_enrouleur_2.stl

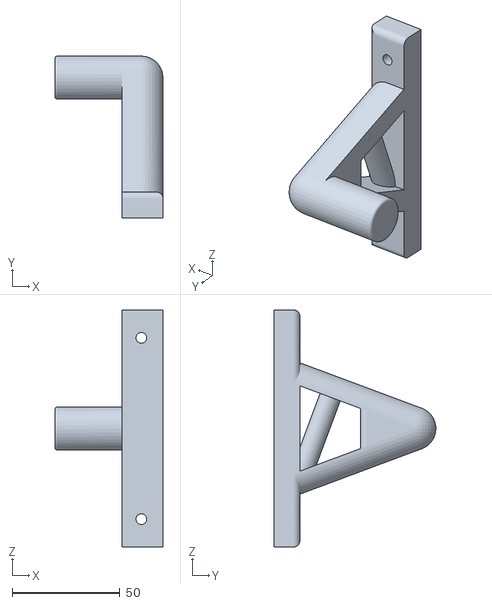
[picture p64: CAD file, 2026-01-15]
hardware/enclosures/body/5b_fixation_enrouleur_2.stl
50.0 x 75.0 x 109.8
