astrolabe-expeditions/LittObs_OSOLAMOS/hardware/enclosures/body/3_mur_arriere.stl

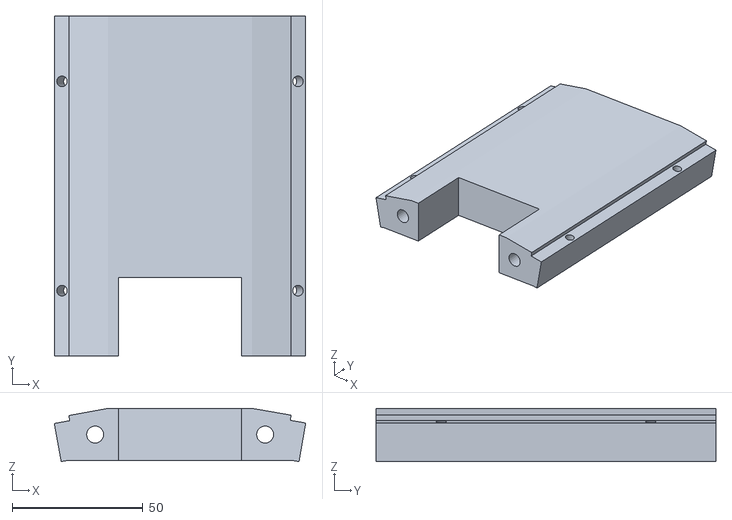
[picture p65: CAD file, 2026-01-15]
hardware/enclosures/body/3_mur_arriere.stl
96.2 x 130.0 x 20.4
