astrolabe-expeditions/LittObs_OSOLAMOS/hardware/enclosures/body/9_mousqueton.stl

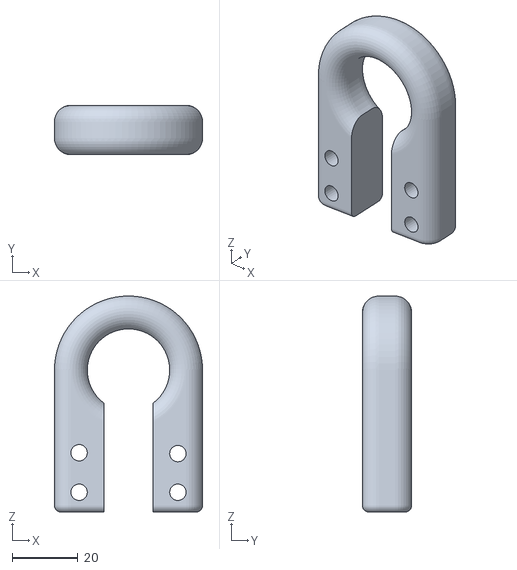
[picture p66: CAD file, 2026-01-15]
hardware/enclosures/body/9_mousqueton.stl
45.0 x 15.0 x 65.6
