astrolabe-expeditions/LittObs_OSOLAMOS/hardware/enclosures/body/2_mur_gauche.stl

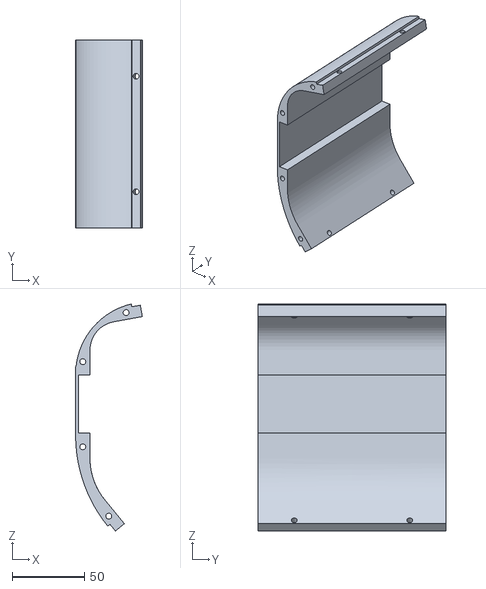
[picture p67: CAD file, 2026-01-15]
hardware/enclosures/body/2_mur_gauche.stl
46.2 x 130.0 x 157.2
