astrolabe-expeditions/LittObs_OSOLAMOS/hardware/enclosures/body/7_porte goupille-2 v10mm.stl

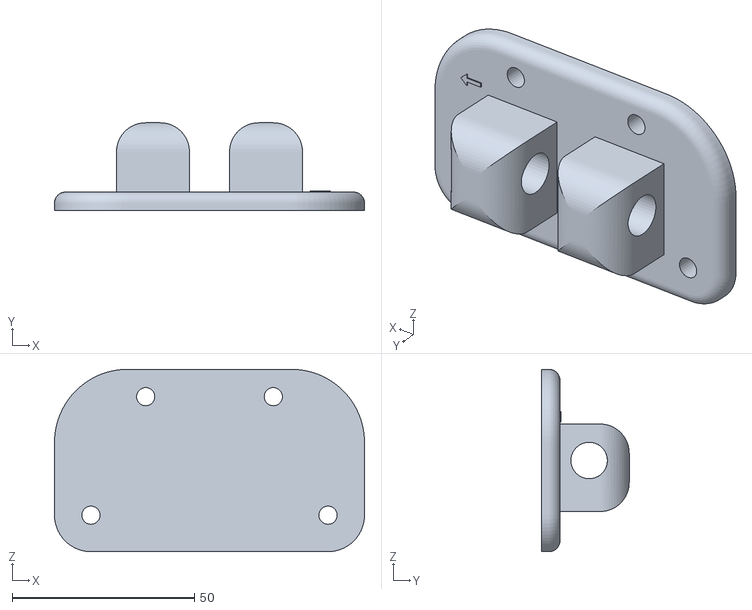
[picture p68: CAD file, 2026-01-15]
hardware/enclosures/body/7_porte goupille-2 v10mm.stl
85.0 x 24.0 x 50.0
