astrolabe-expeditions/LittObs_OSOLAMOS/hardware/enclosures/body/4_mur_droit.stl

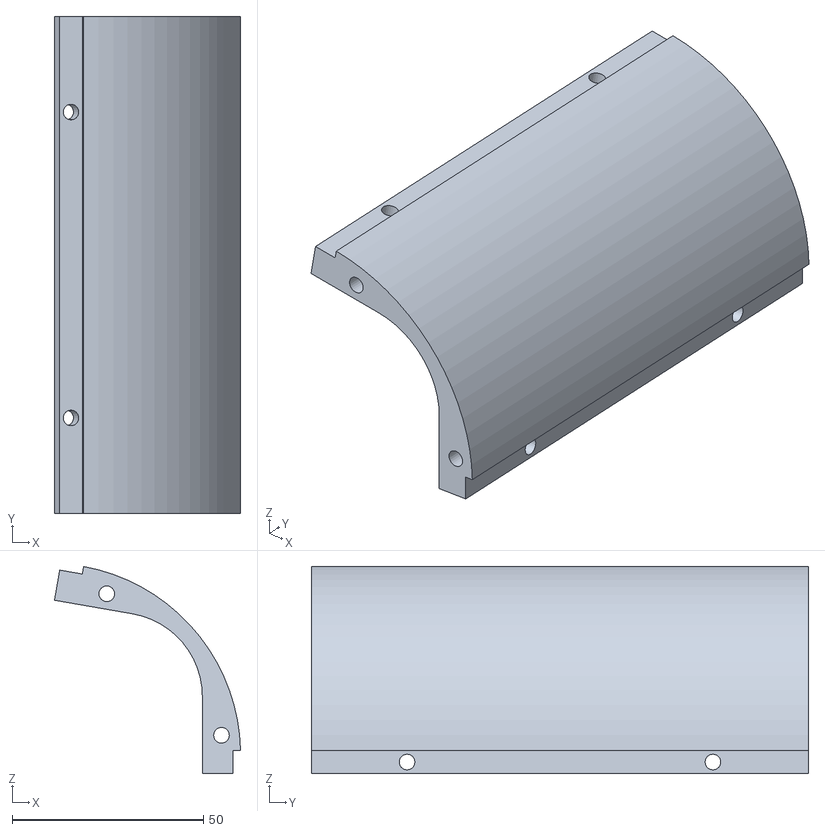
[picture p69: CAD file, 2026-01-15]
hardware/enclosures/body/4_mur_droit.stl
48.7 x 130.0 x 54.1
