astrolabe-expeditions/LittObs_OSOLAMOS/hardware/enclosures/body/1_mur_avant.stl

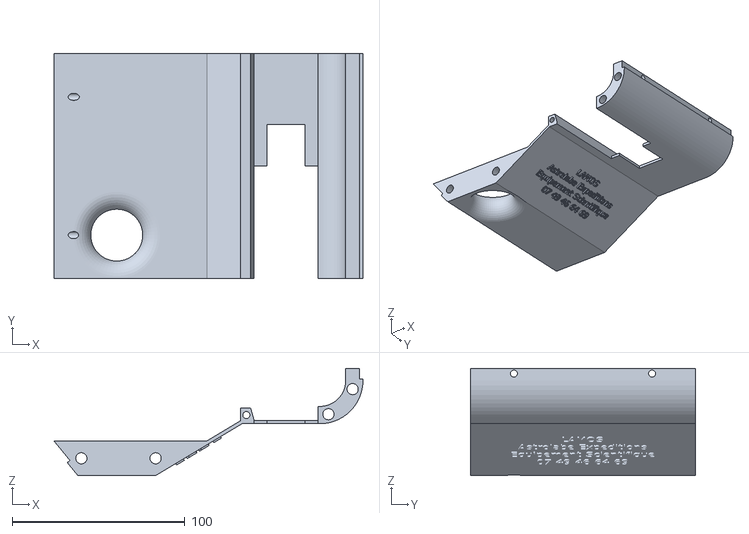
[picture p70: CAD file, 2026-01-15]
hardware/enclosures/body/1_mur_avant.stl
178.8 x 130.0 x 62.0
