astrolabe-expeditions/LittObs_OSOLAMOS/hardware/enclosures/body/8a_8b_attache_tube_64mm_v3.0.stl

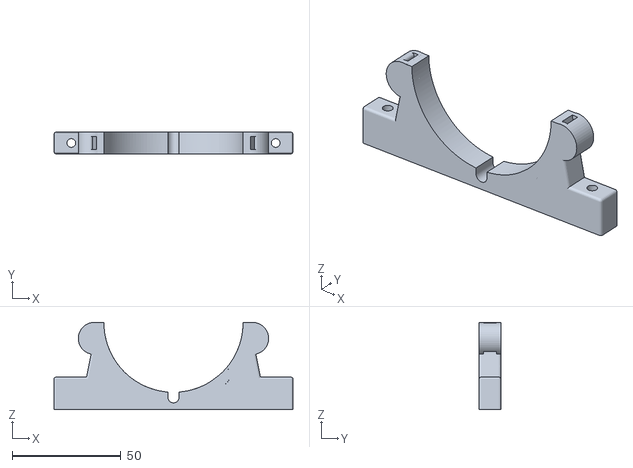
[picture p71: CAD file, 2026-01-15]
hardware/enclosures/body/8a_8b_attache_tube_64mm_v3.0.stl
110.0 x 10.0 x 40.2
