astrolabe-expeditions/LittObs_OSOLAMOS/(list of files, cad)

Other CAD files:
hardware/enclosures/body/5a_fixation_enrouleur_1.stl
hardware/enclosures/body/10_largage_moteur_bielle.f3d
hardware/enclosures/body/11_largage_moteur_cylindre.f3d
hardware/enclosures/body/11_largage_moteur_manivelle.f3d
hardware/enclosures/body/8a_8b_attache_tube_64mm_v3.0.f3d
