astrolabe-expeditions/LittObs_OSOLAMOS/hardware/pcbs/Gerber_PCB_LAMOS_Moteur/How-to-order-PCB.txt

How to Order PCB

Please refer to:
https://docs.easyeda.com/en/PCB/Order-PCB
