astrolabe-expeditions/LittObs_OSOLAMOS/hardware/pcbs/Schematic_PCB_LAMOS_Moteur_2025-04-08.pdf

# MOTOR CONTROL

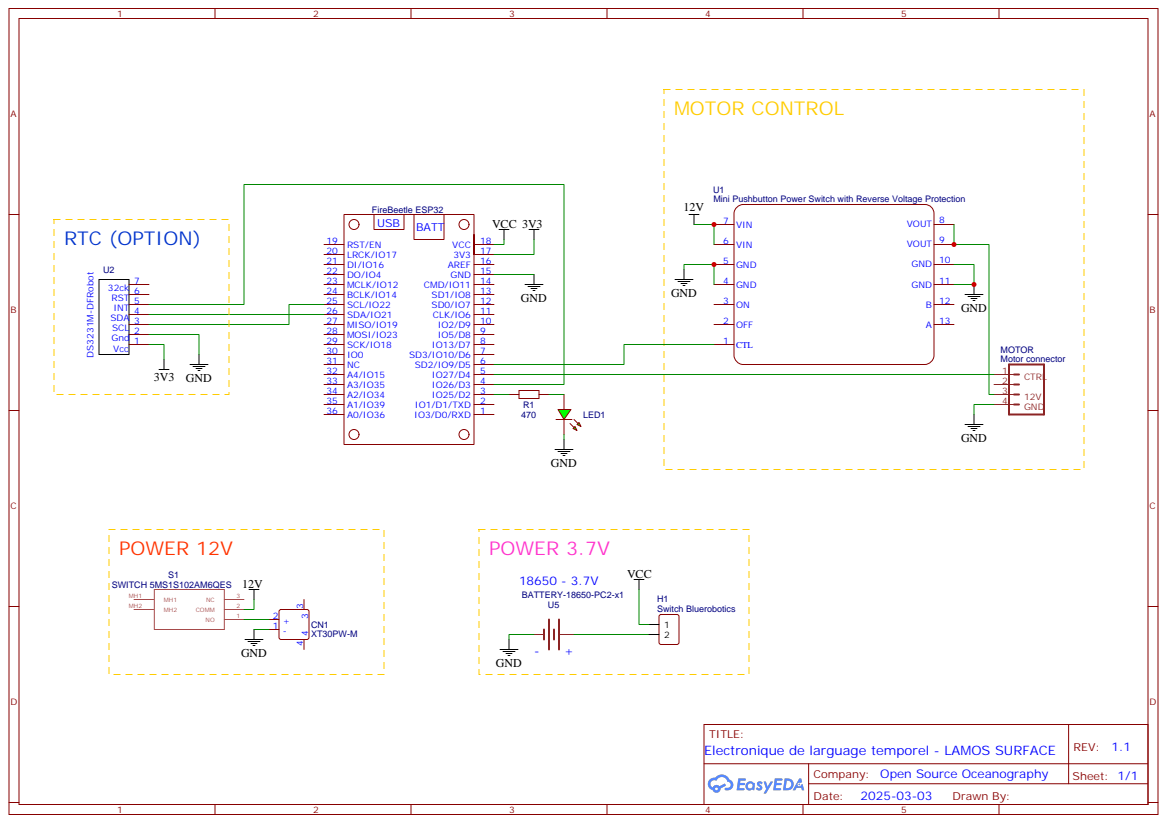
[picture p72: page 1]

Mini Pushbutton Power Switch with Reverse Voltage Protection

Company: Open Source Oceanography
