astrolabe-expeditions/LittObs_OSOLAMOS/hardware/pcbs/PCB_LAMOS_Moteur_2025-04-08.pdf

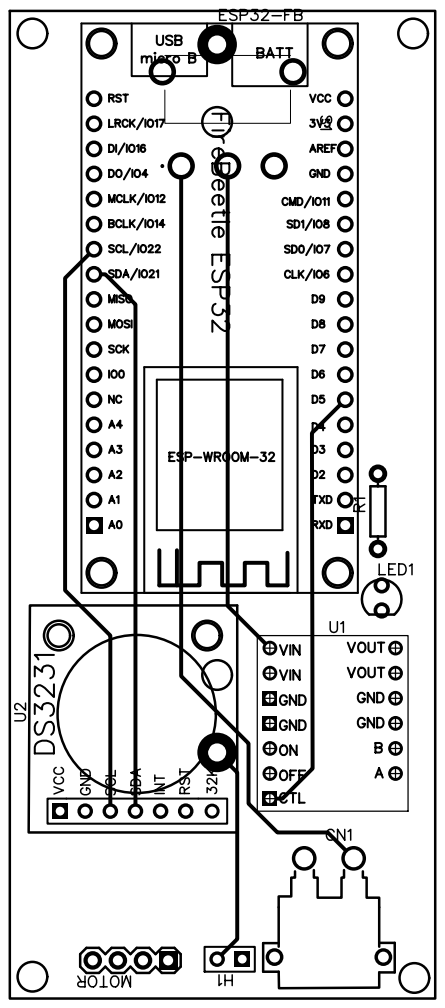
[picture p73: page 1]
