astrolabe-expeditions/LittObs_OSOLAMOS/docs/.gitbook/assets/12_14_15.a_15.b_murs_LAMOS.pdf

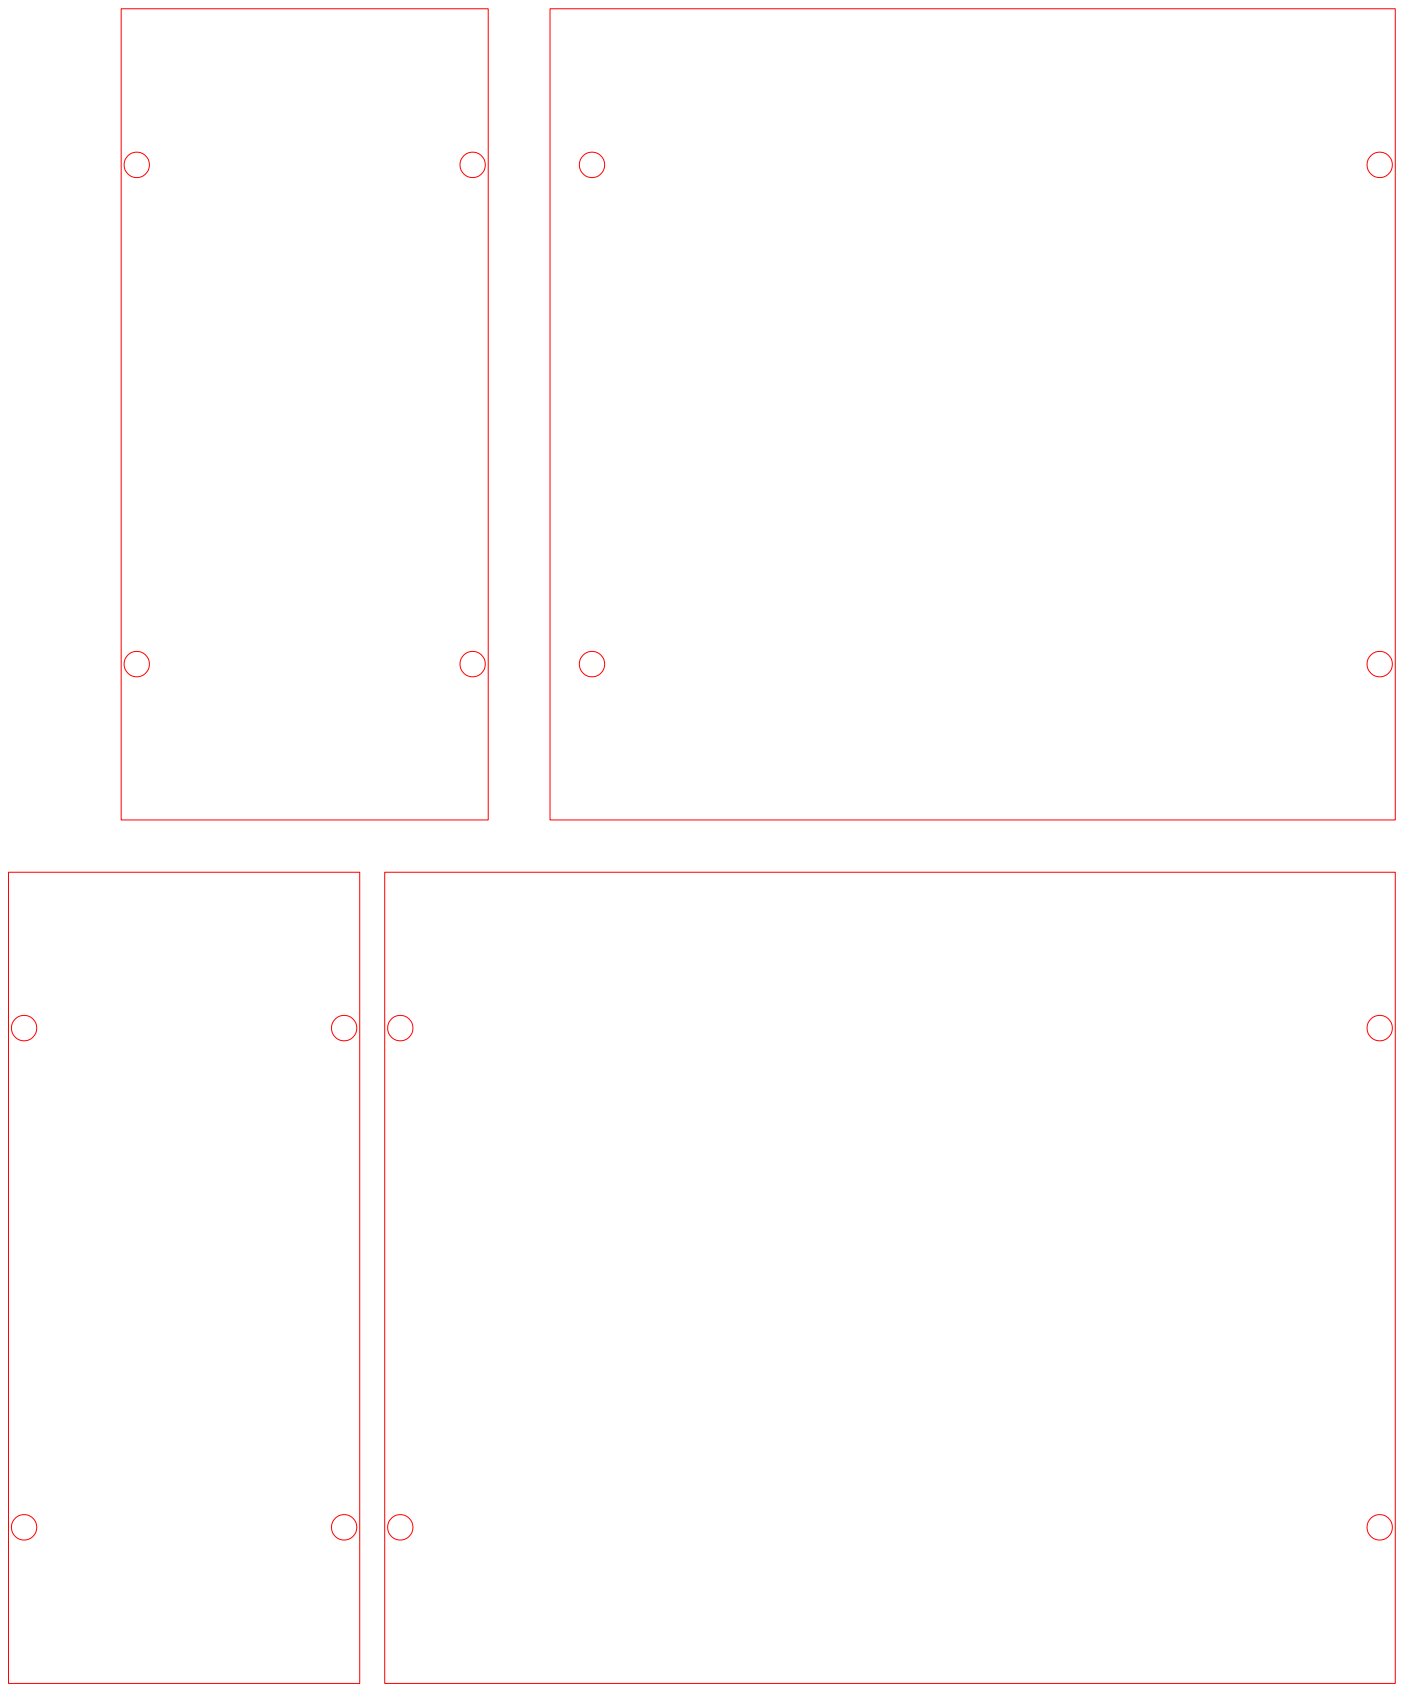
[picture p74: page 1]
