astrolabe-expeditions/LittObs_OSOLAMOS/docs/.gitbook/assets/17_Face A_LAMOS.pdf

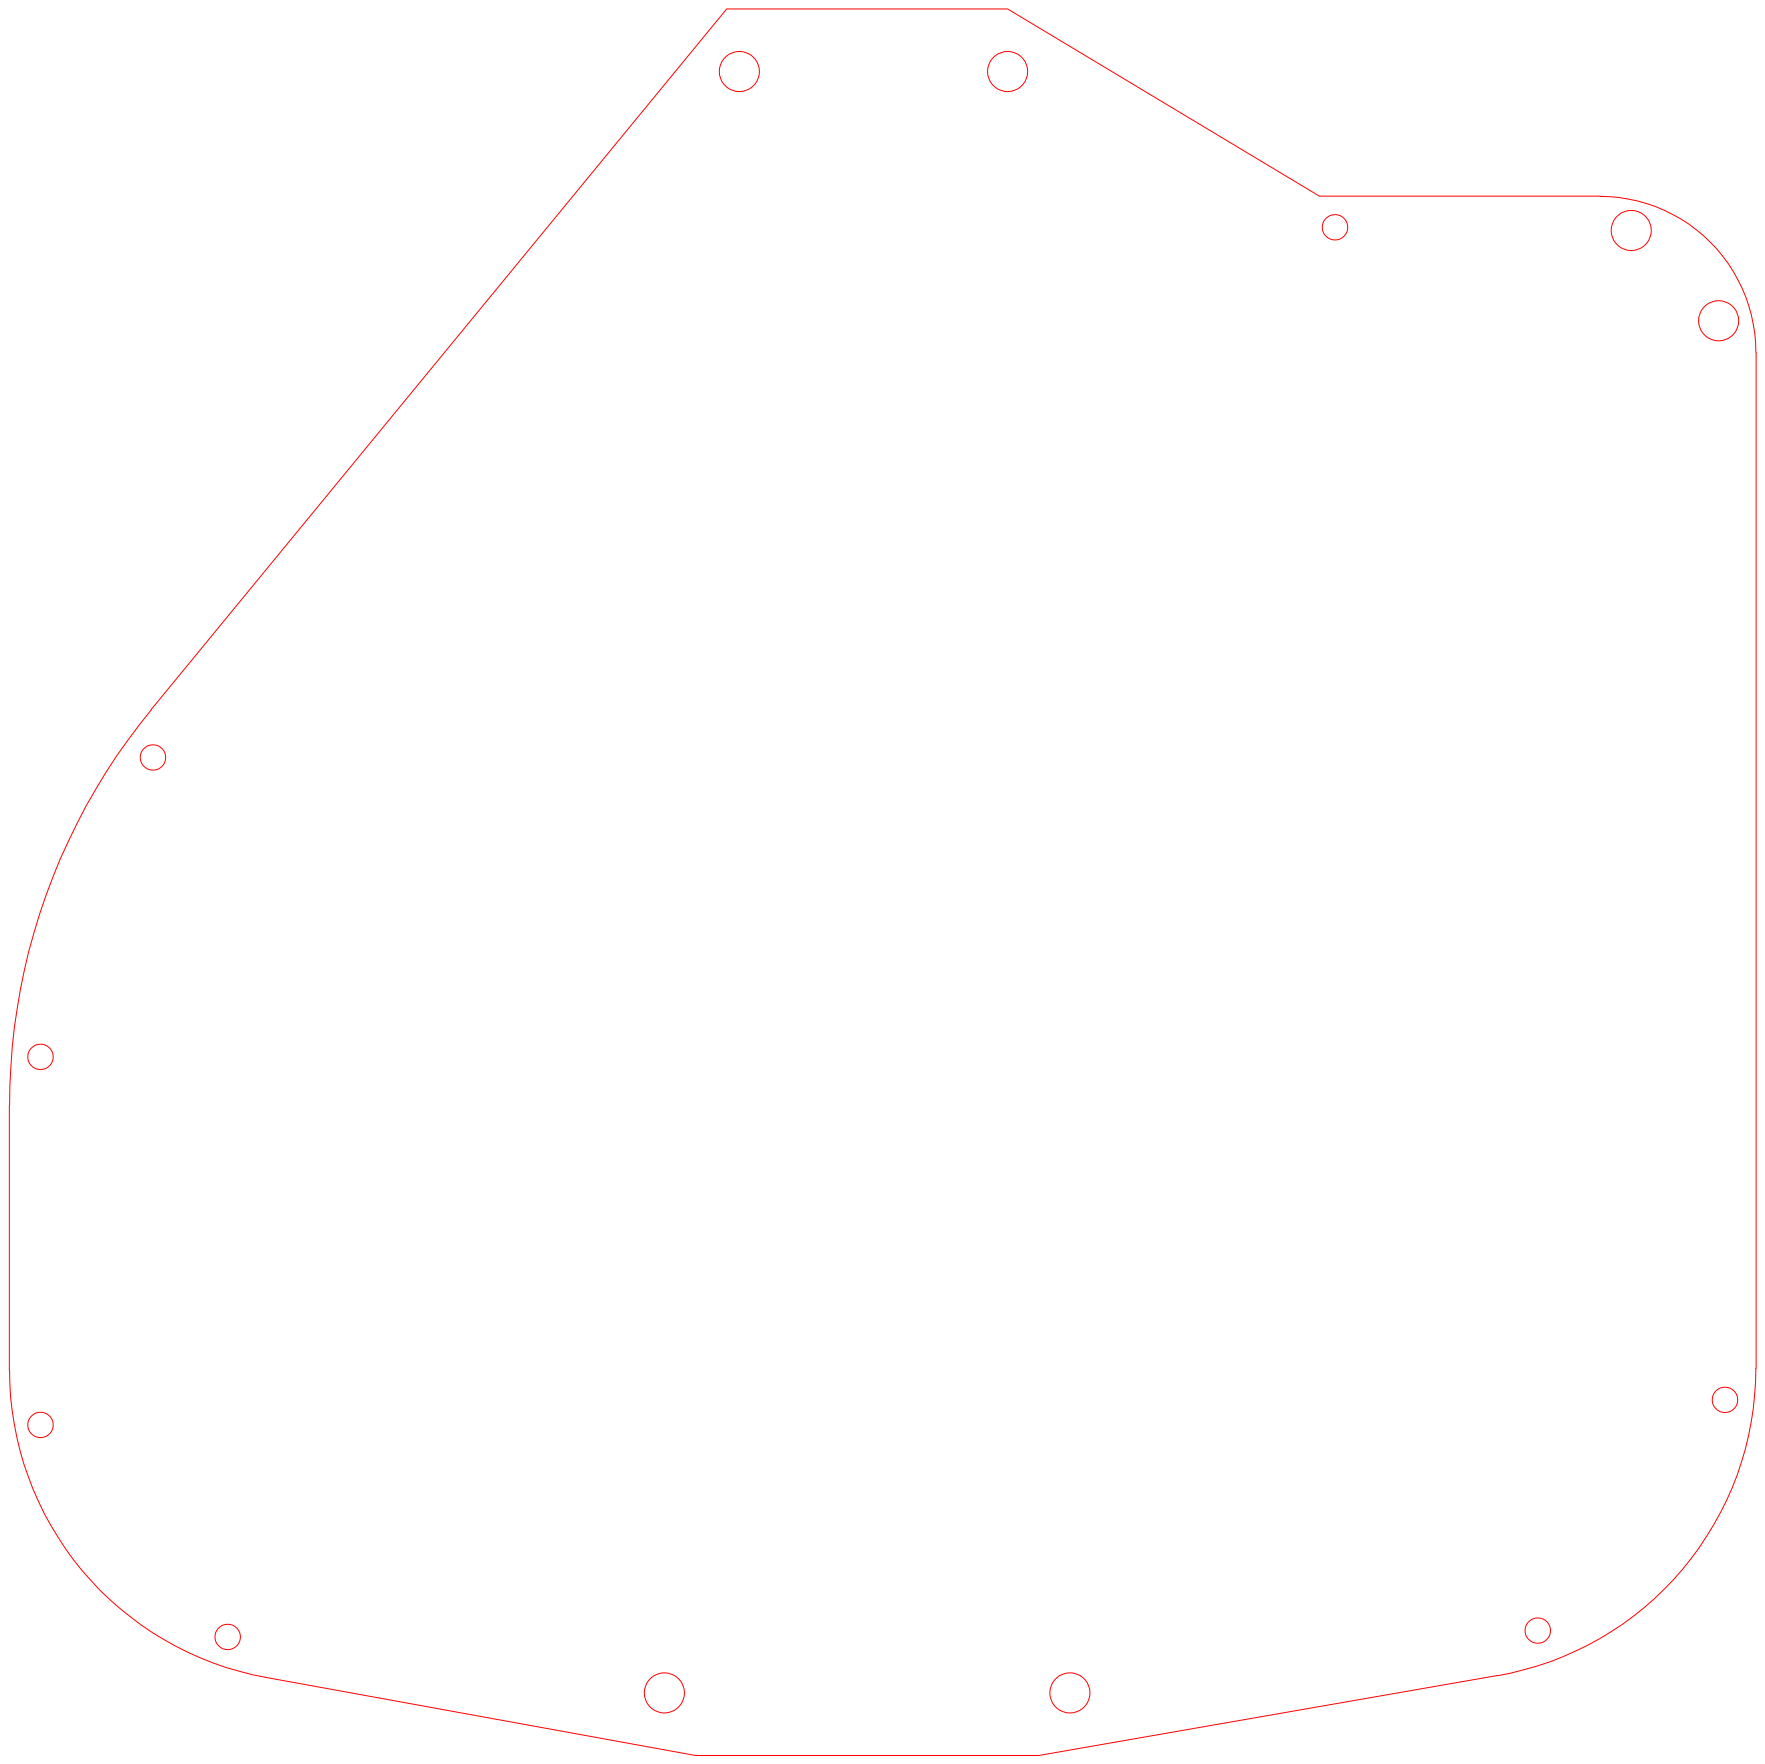
[picture p75: page 1]
