astrolabe-expeditions/LittObs_OSOLAMOS/docs/.gitbook/assets/18_Face B_LAMOS.pdf

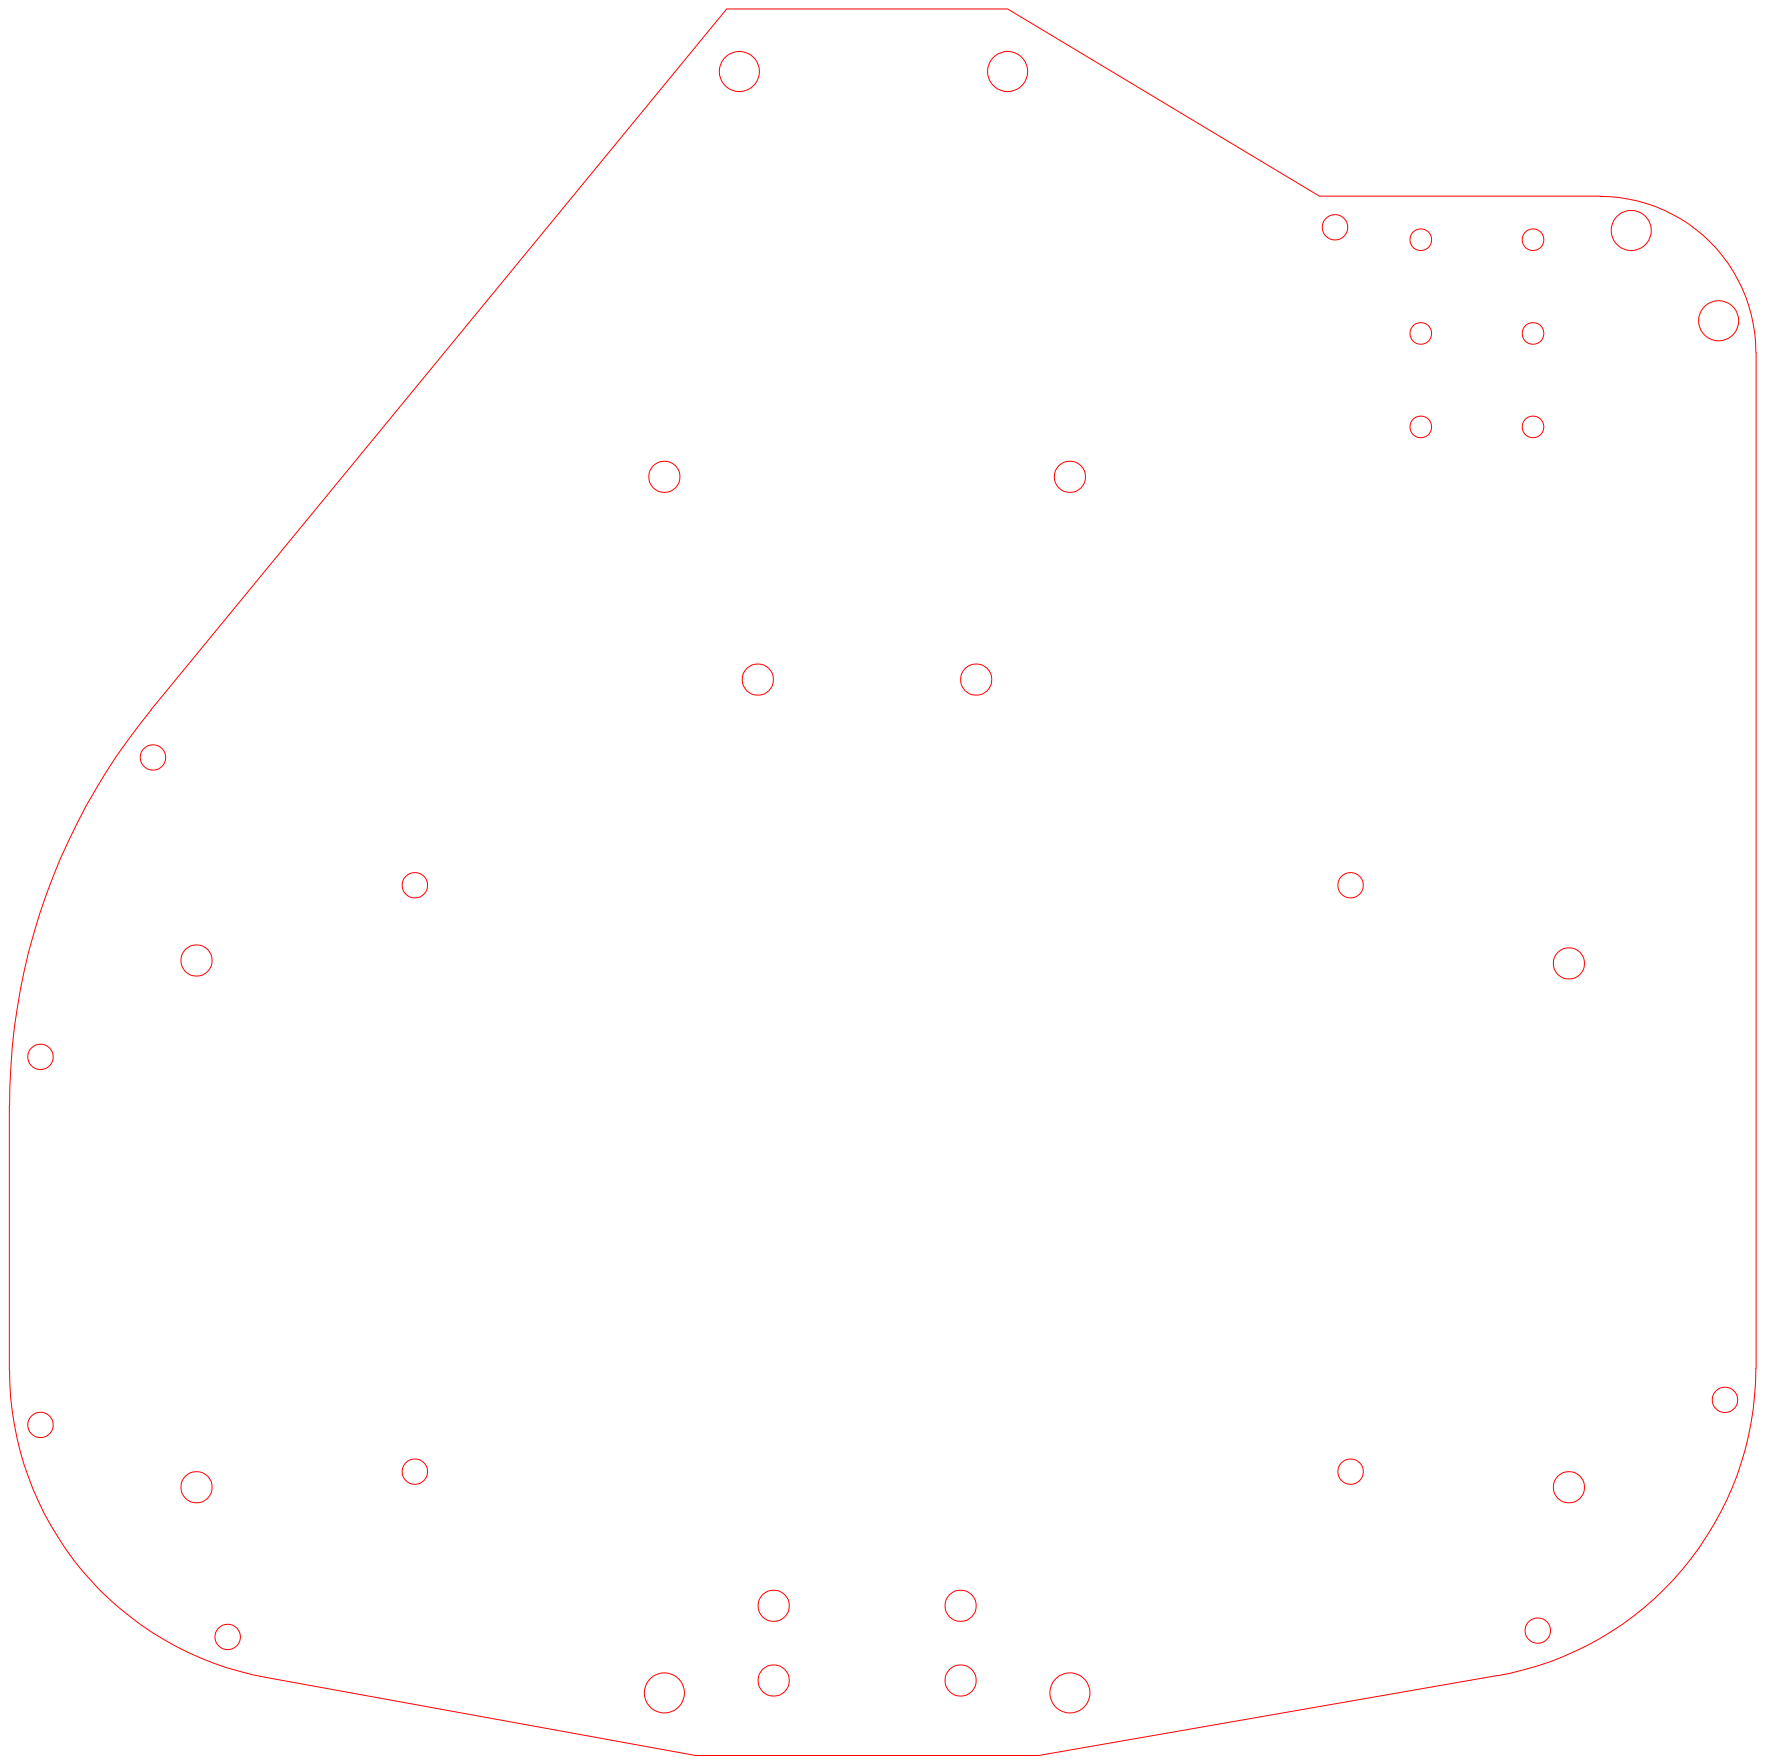
[picture p76: page 1]
