astrolabe-expeditions/LittObs_OSOLAMOS/(list of files, drawings)

Other design files:
hardware/pcbs/SCH_PCB_LAMOS_Moteur_2025-04-08.json
