astrolabe-expeditions/LittObs_OSOLAMOS/(commit log)

2023-10-08 refactor : removed useless libraries, added stdout printer
2023-10-10 fix : if flag_end is true, reset all variable. If the symbol counter is zero at the end of a symbol timer, return empty message
2023-10-18 refactor : prettier tx_main.py, refactored config.json and release_sequences.json (the release and wake up tones are now attached to an ID
2023-11-13 chore : beginning of the arduino implementation
2024-01-17 Added largueur temporel arduino code
2024-01-28 refactor: switch from unittest to pytest
2024-09-24 Create LAMOS_moteur_v1.0.ino
    Adapt LAMOS software to use it with stepper motor
2025-09-30 refactor: Move Arduino code inside its own file
2025-09-30 feat: Switch from burnwire release to motor
    This commit only merges the code from the version with the motor in the previous version. This aims to improve readability and tracking of changes in the code. The work was done by BrendanSig.
    [Largueur_temporel.ino]
2025-09-30 feat: Reserve space for enclosures and pcbs
2026-01-15 docs(GitBook-17): No subject
    [1_mur_avant.stl, 2_mur_gauche.stl, 3_mur_arriere.stl, 4_enrouleur.stl, 4_mur_droit.stl, 5.a_fixation_enrouleur_1.stl, 5.b_fixation_enrouleur_2.stl, 6_enrouleur.stl]
2026-02-19 Ajout du fichier apk de l'application mobile
2026-02-19 Ajout fichiers gerber PCB LAMOS
    [SCH_PCB_LAMOS_Moteur_2025-04-08.json]
2026-02-19 feat: Extract gerber files into a folder
    [Drill_NPTH_Through.DRL, Drill_PTH_Through.DRL, Drill_PTH_Through_Via.DRL, Gerber_BoardOutlineLayer.GKO, Gerber_BottomLayer.GBL, Gerber_BottomSilkscreenLayer.GBO, Gerber_BottomSolderMaskLayer.GBS, Gerber_TopLayer.GTL]
2026-02-19 feat: add LAMOS enclosure files
    [Enrouleur_colerette.stl, attache_tube_64mm_v3.0.f3d, attache_tube_64mm_v3.0.stl, attache_tube_BlueRobotics.stl, complete_LAMOS.stl, fixation_enrouleur_1.stl, fixation_enrouleur_2.stl, largage_moteur_bielle.f3d]
2026-02-23 feat: add LAMOS files
    [PCB_Holder.stl, PCB_Support.stl, Sensor_Protection.stl]
2026-02-23 refactor: rename enclosure files to fit with gitbook
    [10_largage_moteur_bielle.f3d, 10_largage_moteur_bielle.stl, 11_largage_moteur_cylindre.f3d, 11_largage_moteur_cylindre.stl, 11_largage_moteur_manivelle.f3d, 11_largage_moteur_manivelle.stl, 1_mur_avant.stl, 2_mur_gauche.stl]
